pablo18393/in3ator/IN3_hardware/V6/Released/BOM/BOM_PartType-in3ator.xls

Comment | Description | Quantity | Designator
PS1420P02CT | BUZZER, PIEZO, 70DB, 14MM; Transducer Function: Buzzer; Tones: Low Frequency; Supp | 1.0 | BUZ1
100uF 25V 105º SMD 6.6x6.6mm D=6.3mm | 100uF 25V 105º SMD 6.6x6.6mm D=6.3mm | 3.0 | C1, C5, C8
1uF 0603 X5R 16V | 1uF 0603 X5R 16V | 10.0 | C2, C7, C12, C13, C14, C15, C25, C26, C27, C28
10uF 0603 X5R 6.3V | 10uF 0603 X5R 6.3V | 2.0 | C4, C6
100nF 0603 X7R 25V | 100nF 0603 X7R 25V | 11.0 | C9, C11, C19, C22, C24, C29, C30, C31, C32, C33, C35
470uF 16V 105º D=10mm R=5mm | 470uF 16V 105º D=10mm R=5mm | 1.0 | C10
18pF 0603 NPO 5% 50V | 18pF 0603 NPO 5% 50V | 2.0 | C16, C18
1uF 0603 X5R 16V | 1uF 0603 X5R 16V | 1.0 | C17
22pF 0603 NPO 5% 50V | 22pF 0603 NPO 5% 50V | 1.0 | C23
SMBJ15CA | SMBJ15 Series 24.4 V 600 W Bi-Directional Transient Voltage Suppressor-DO-214AA | 1.0 | D1
MBR2045CTI | Schottky Rectifier TO251 Tube 75PCS | 1.0 | D2
ON Semiconductor BAS16HT1G | Diode; Rectifier; Switching; Vr 75VDC; If 200mA; Pkg SOD-323; Vf 1250mV; Trr 6ns; Cj 2pF | 1.0 | D3
S1B....S1M (DO-214) | S1B....S1M (DO-214) | 1.0 | D4
ESDA6V1-5SC6 | ESDA Series 5 Channel 6.1 V 50 pF SMT Uni Directional Transil? Array - SOT-23-6L | 1.0 | D5
Littelfuse 52000001009 + 10A 5X20mm cartridge fuse | Fuse Clip with Ear Through Hole Bulk + 10A 5X20mm cartridge fuse | 1.0 | F1
CG0603MLA-18KE | Var MOV 14VAC 18VDC 30A 24.2V 0603 SMD Paper T/R Var MOV 14VAC 18VDC 30A 24.2V 0603 SMD Paper T/R | 1.0 | F2
BLM18HG601SN1D | BLM18HG601SN1D | 1.0 | FB1
Fiducial | Fiducial | 2.0 | FID1, FID2
Degson 2EDGK-5.08-02P-14-00AH | Terminal block, 5mm 2 Pos, through hole male. | 1.0 | J1
Degson 2EDGK-5.08-04P-14-00AH | Terminal block, 5.08mm 4 Pos, through hole male. | 1.0 | J4
Camden Boss CTBP93HD/8 | 3.5mm pluggable terminal block, header, 8P | 1.0 | J5
JST B2B-XH-A(LF)(SN) | XH Series 2 Position 2.5 mm Pitch Through Hole Top Entry Shrouded Header | 2.0 | J7, J10
JST B3B-XH-A (LF)(SN) | XH Series 3 Position 2.5 mm Pitch Through Hole Crimp Top Entry Shrouded Header | 1.0 | J9
TE Connectivity 2-1761603-1 | Wire-To-Board Connector, AMP-LATCH Series, Through Hole, Header, 6, 2.54 mm, Gold Plated Contacts | 1.0 | J11
SYM-d1a918a3c97c0e6e-1 | Relay; E-Mech; Gen Purp; DPDT; Cur-Rtg 8A; Ctrl-V 12DC; Vol-Rtg 277/30AC/DC; PCB Mnt | 1.0 | K1
Bourns SRN6045TA-221M | Inductor Power Semi-Shielded Wirewound 220uH 20% 1MHz 15Q-Factor Ferrite 0.6A 0.9Ohm DCR 2424 Automotive T/R | 1.0 | L1
Murata NCP18XH103F03RB | Thermistor NTC 10K Ohm 1% 2-Pin 0603 Surface Mount Solder Pad 3434K T/R | 2.0 | NTC1, NTC2
BC817-16 | TRANS NPN 45V 500mA SMD SOT23-3 | 3.0 | Q1, Q2, Q9
IRLB8314PbF | MOSFET Transistor, N Channel, 130 A, 30 V, 0.0019 ohm, 10 V, 1.7 V | 1.0 | Q3
STP40NF03L | STP40NF03L | 5.0 | Q4, Q5, Q6, Q7, Q8
NTR1P02LT1G | Power MOSFET, -20 V, -1.3 A, P-Channel, 3-Pin SOT-23, Pb-Free, Tape and Reel | 1.0 | Q10
0.02R 1206 0.5W 1% | 0.02R 1206 0.5W 1% | 2.0 | R3, R4
10K 0603 0.1W 1% | 10K 0603 0.1W 1%, 10K 0603 0.1W 1%, 10K 0603 0.1W 1%, 10K 0603 0.1W 1%, 10K 0603 0.1W 1%, 10K 0603 0.1W 1%, 10K 0603 0.1W 1%, 10K 0603 0.1W 1%, 10K 0603 0.1W 1%, 10K 0603 0.1W 1%, 10K 0603 0.1W 1%, 10K 0603 0.1W 1%, 10K 0603 0.1W 1%, 10K 0603 0.1W 1%, 10K 0603 0.1W 1%, 10K 0603 0.1W 1%, 10K 0603 0.1W 1%, 10K 0603 0.1W 1%, 10K 0603 0.1W 1%, 10K 0603 0.1W 1%, 30K 0603 0.1W 1%, 10K 0603 0.1W 1% | 22.0 | R5, R7, R10, R11, R13, R14, R21, R27, R37, R40, R45, R46, R50, R52, R53, R54, R57, R58, R59, R62, R68, R72
30K 0603 0.1W 1% | 30K 0603 0.1W 1% | 3.0 | R6, R30, R61
4K7 0603 0.1W 1% | 4K7 0603 0.1W 1% | 2.0 | R8, R36
2K 0603 0.1W 1% | 2K 0603 0.1W 1% | 3.0 | R9, R12, R29
22R 0603 0.1W 1% | 22R 0603 0.1W 1% | 5.0 | R15, R16, R32, R33, R34
100R 0603 0.1W 1% | 100R 0603 0.1W 1% | 8.0 | R17, R18, R19, R20, R22, R23, R65, R69
0R 0603 0.1W 1% | 0R 0603 0.1W 1% | 5.0 | R24, R31, R66, R70, R81
1K 0603 0.1W 1% | 1K 0603 0.1W 1% | 7.0 | R25, R26, R28, R55, R60, R63, R64
100K 0603 0.1W 1% | 100K 0603 0.1W 1% | 4.0 | R35, R42, R47, R48
22K 0603 0.1W 1% | 22K 0603 0.1W 1% | 3.0 | R44, R49, R51
TE Connectivity 5-1814832-1 | RF Connectors / Coaxial Connectors Str PCB Skt | 1.0 | RF_CON1
Bourns PEC11R-4215F-S0024 | 12 mm Incremental Encoder, 24 Detent, -30 to 70 degC, 5-Pin THD, RoHS, Bulk | 1.0 | SW2
MCP1703T-3302E/CB | MCP1703T-3302E/CB | 2.0 | U1, U2
Micrel MIC29302WU | MIC29302 Series 3 A 1.24 to 26 V ADJ Output Voltage LDO Regulator - TO-263-5 | 1.0 | U3
MCP1703T-5002E/CB | 250 mA, 16V, Low Quiescent Current LDO Regulator, 3-Pin SOT-23A, Extended Temperature, Tape and Reel | 1.0 | U4
STM32F103RET6 | ARM Cortex-M3 32-bit MCU, 512 KB Flash, 64 KB Internal RAM, 51 I/Os, 64-pin LQFP, -40 to 85 degC, Tray | 1.0 | U5
Simcom SIM800C | Module: GSM/Bluetooth; GPRS; 2G; 1800MHz, 900MHz; 85.6kbps; SMD | 1.0 | U6
MCP6L02T-E/MS | Microchip MCP6L02T-E/MS, Dual Op Amp, 1MHz Rail-Rail, 1.8 to 6 V, 8-Pin MSOP | 1.0 | U8
2.2 / 2.4 tft compatible (touch / no touch) | TZT 2.4" 240x320 SPI TFT LCD Serial Port Module+5V/3.3V PBC Adapter Micro SD ILI9341 | 1.0 | U10
Bosch BME280 | Combined humidity and pressure sensor | 1.0 | U11
CX5032GB08000H0HPQZ1 | Crystal 8Mhz 30ppm -40ºC/+85ºC 12pF 300ohm | 1.0 | Y1
