pablo18393/in3ator/IN3_hardware/V2.B/Released/in3ator.PDF

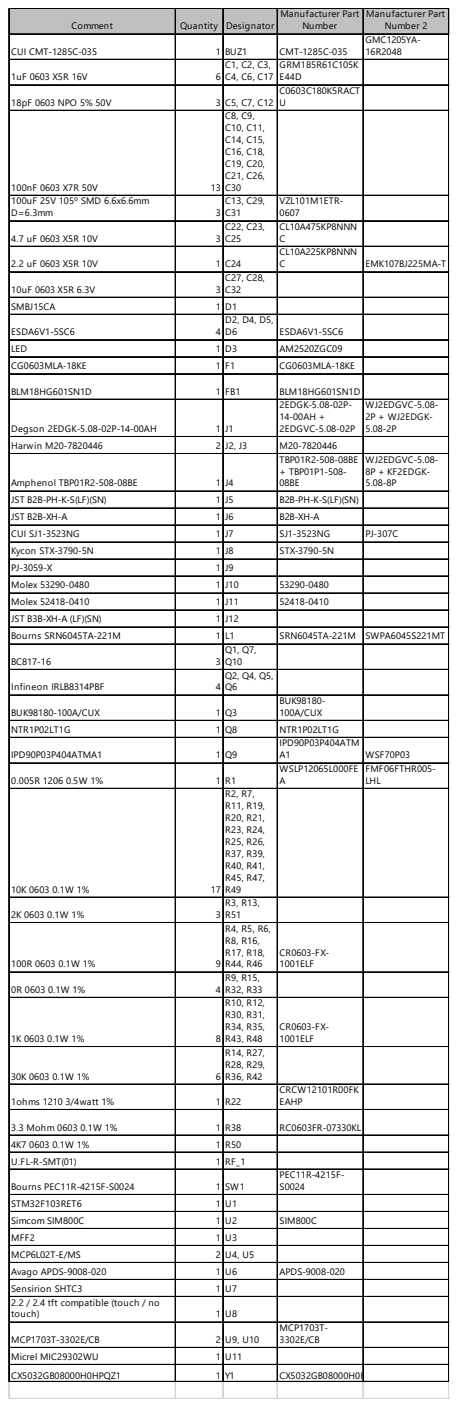
[picture p1: page 1]

Comment | Quantity | Designator | Manufacturer Part Number | Manufacturer Part Number 2

CUI CMT-1285C-035 | 1 | BUZ1 | CMT-1285C-035 | GMC1205YA-16R2048

1uF 0603 X5R 16V | 6 | C1, C2, C3, C4, C6, C17 | GRM185R61C105K E44D

18pF 0603 NPO 5% 50V | 3 | C5, C7, C12 | C0603C180K5RACT U

100uF 25V 105º SMD 6.6x6.6mm D=6.3mm | 3 | C13, C29, C31 | VZL101M1ETR-0607

4.7 uF 0603 X5R 10V | 3 | C22, C23, C25 | CL10A475KP8NNN C

2.2 uF 0603 X5R 10V | 1 | C24 | CL10A225KP8NNN C | EMK107BJ225MA-T

SMBJ15CA | 1 | D1
ESDA6V1-5SC6 | 4 | D2, D4, D5, D6 | ESDA6V1-5SC6

LED | 1 | D3 | AM2520ZGC09

CG0603MLA-18KE | 1 | F1 | CG0603MLA-18KE

BLM18HG601SN1D | 1 | FB1 | BLM18HG601SN1D
Degson 2EDGK-5.08-02P-14-00AH | 1 | J1 | 2EDGK-5.08-02P-14-00AH + 2EDGVC-5.08-02P | WJ2EDGVC-5.08-2P + WJ2EDGK-5.08-2P

Harwin M20-7820446 | 2 | J2, J3 | M20-7820446
Amphenol TBP01R2-508-08BE | 1 | J4 | TBP01R2-508-08BE + TBP01P1-508-08BE | WJ2EDGVC-5.08-8P + KF2EDGK-5.08-8P

JST B2B-PH-K-S(LF)(SN) | 1 | J5 | B2B-PH-K-S(LF)(SN)

JST B2B-XH-A | 1 | J6 | B2B-XH-A

CUI SJ1-3523NG | 1 | J7 | SJ1-3523NG | PJ-307C

Kycon STX-3790-5N | 1 | J8 | STX-3790-5N

Molex 53290-0480 | 1 | J10 | 53290-0480

Molex 52418-0410 | 1 | J11 | 52418-0410

JST B3B-XH-A (LF)(SN) | 1 | J12

Bourns SRN6045TA-221M | 1 | L1 | SRN6045TA-221M | SWPA6045S221MT
BC817-16 | 3 | Q1, Q7, Q10

Infineon IRLB8314PBF | 4 | Q2, Q4, Q5, Q6

BUK98180-100A/CUX | 1 | Q3 | BUK98180-100A/CUX

NTR1P02LT1G | 1 | Q8 | NTR1P02LT1G
IPD90P03P404ATMA1 | 1 | Q9 | IPD90P03P404ATM A1 | WSF70P03

0.005R 1206 0.5W 1% | 1 | R1 | WSLP12065L000FE A | FMF06FTHR005-LHL

100R 0603 0.1W 1% | 9 | R4, R5, R6, R8, R16, R17, R18, R44, R46 | CR0603-FX-1001ELF

1K 0603 0.1W 1% | 8 | R10, R12, R30, R31, R34, R35, R43, R48 | CR0603-FX-1001ELF

1ohms 1210 3/4watt 1% | 1 | R22 | CRCW12101R00FK EAHP

3.3 Mohm 0603 0.1W 1% | 1 | R38 | RC0603FR-07330KL

U.FL-R-SMT(01) | 1 | RF_1
Bourns PEC11R-4215F-S0024 | 1 | SW1 | PEC11R-4215F-S0024

STM32F103RET6 | 1 | U1

Simcom SIM800C | 1 | U2 | SIM800C

MFF2 | 1 | U3

MCP6L02T-E/MS | 2 | U4, U5

Avago APDS-9008-020 | 1 | U6 | APDS-9008-020

Sensirion SHTC3 | 1 | U7
2.2 / 2.4 tft compatible (touch / no touch) | 1 | U8

MCP1703T-3302E/CB | 2 | U9, U10 | MCP1703T-3302E/CB

Micrel MIC29302WU | 1 | U11

CX5032GB08000H0HPQZ1 | 1 | Y1 | CX5032GB08000H0H

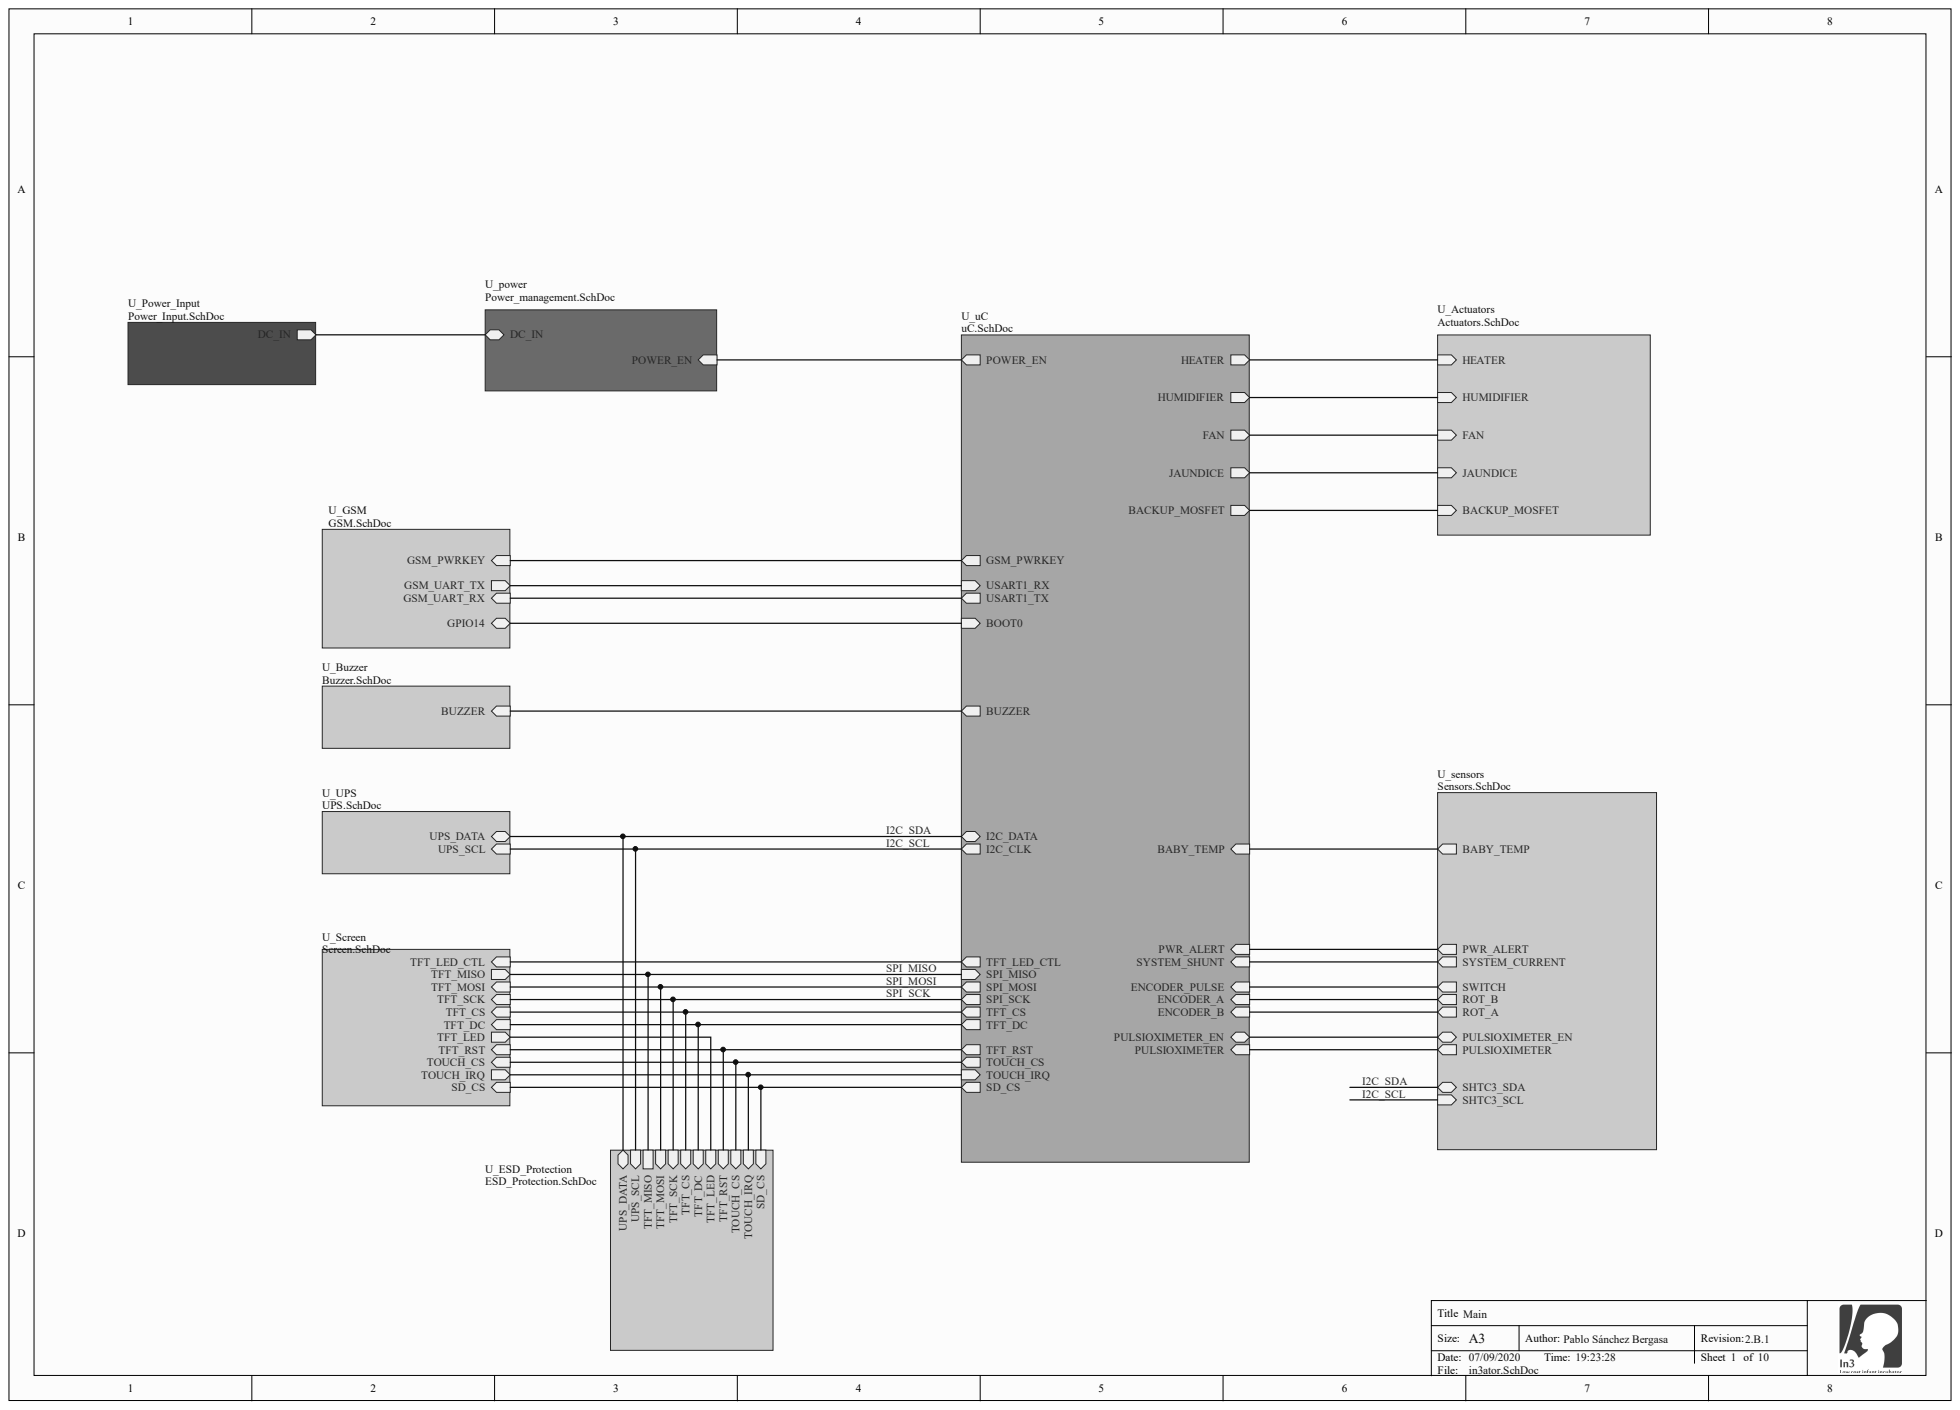
[picture p2: page 2]
Title Size:; Author; ROT_B ROT_A PULSIOXIMETER_EN SHTC3_SCL SHTC3_SDA PWR_ALERT PULSIOXIMETER BABY_TEMP; POWER_EN BOOT0; I2C_CLK SPI_MISO SPI_SCK SPI_MOSI; IOXIMETER PWR_ALERT; chDoc DC_IN; FAN BACKUP_MOS; I2C_SDA I2C_SCL

NLSPI0MISO S P I_MI S O
NLSPI0MOSI S P I_MOS I
NLSPI0SCK S P I_S C K

Main

A | : P ablo S ánche z B e rgasa | R evision: 2.B.1

File : in3ator.S chDoc

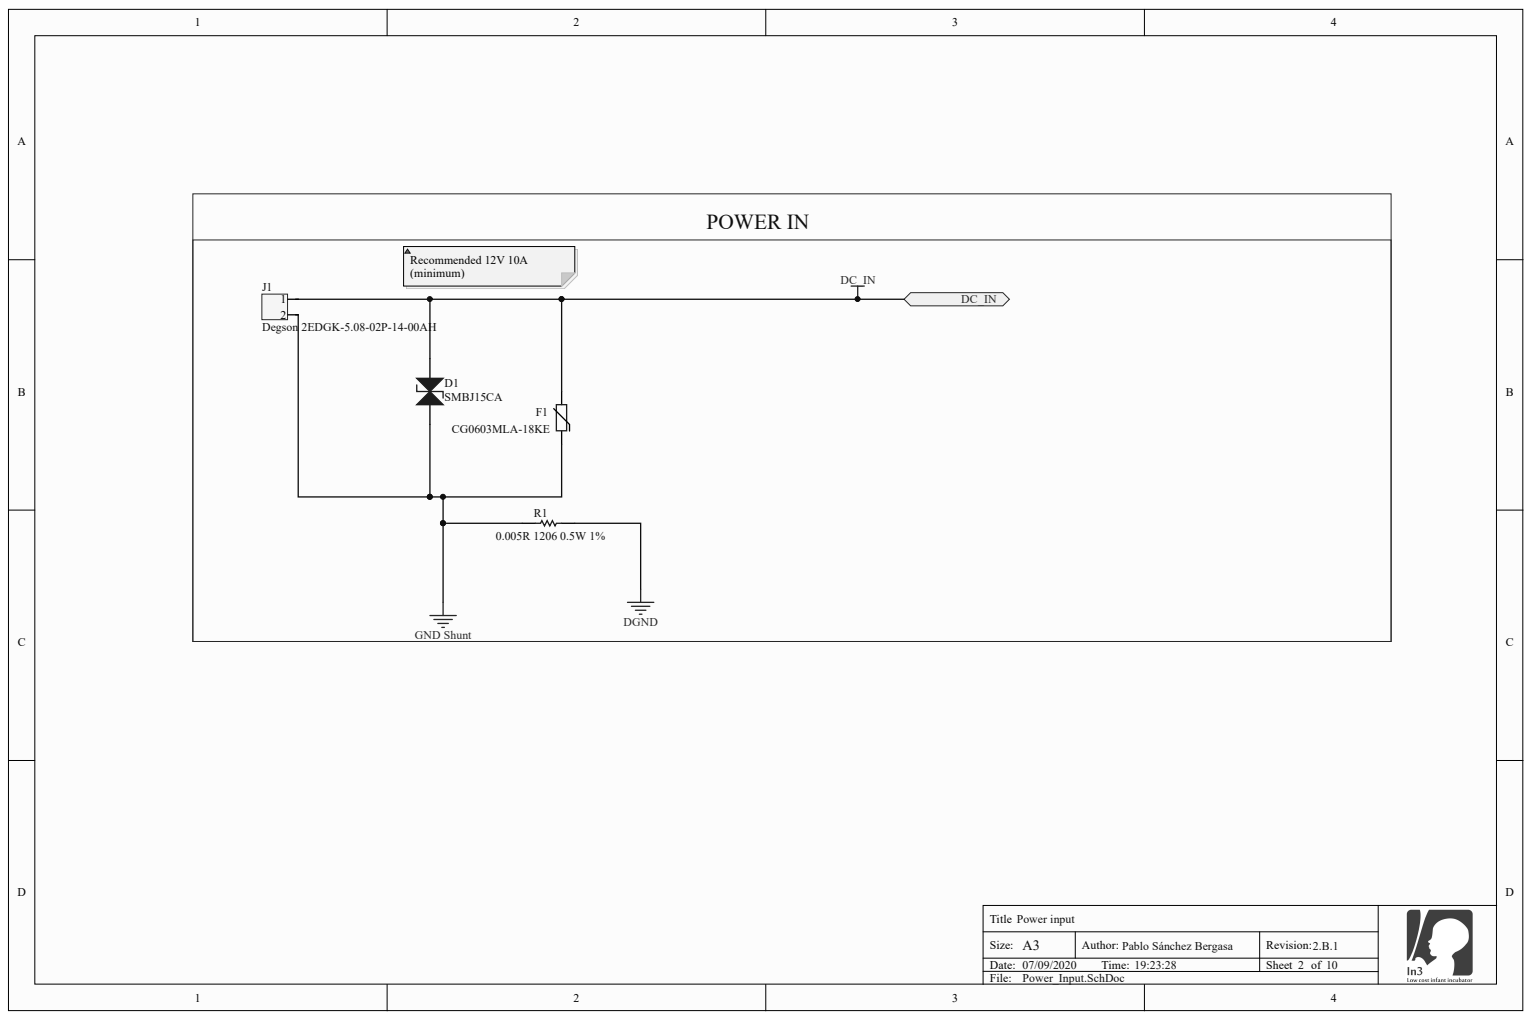
[picture p3: page 3]
POWER IN; D Shunt; J1Degson 2ED; mended 12V 10A

T i t l e Power input

Size: A3 | Author: Pablo S ánchez Bergasa | Revision: 2. B . 1
Date: T i me: | | Sheet of

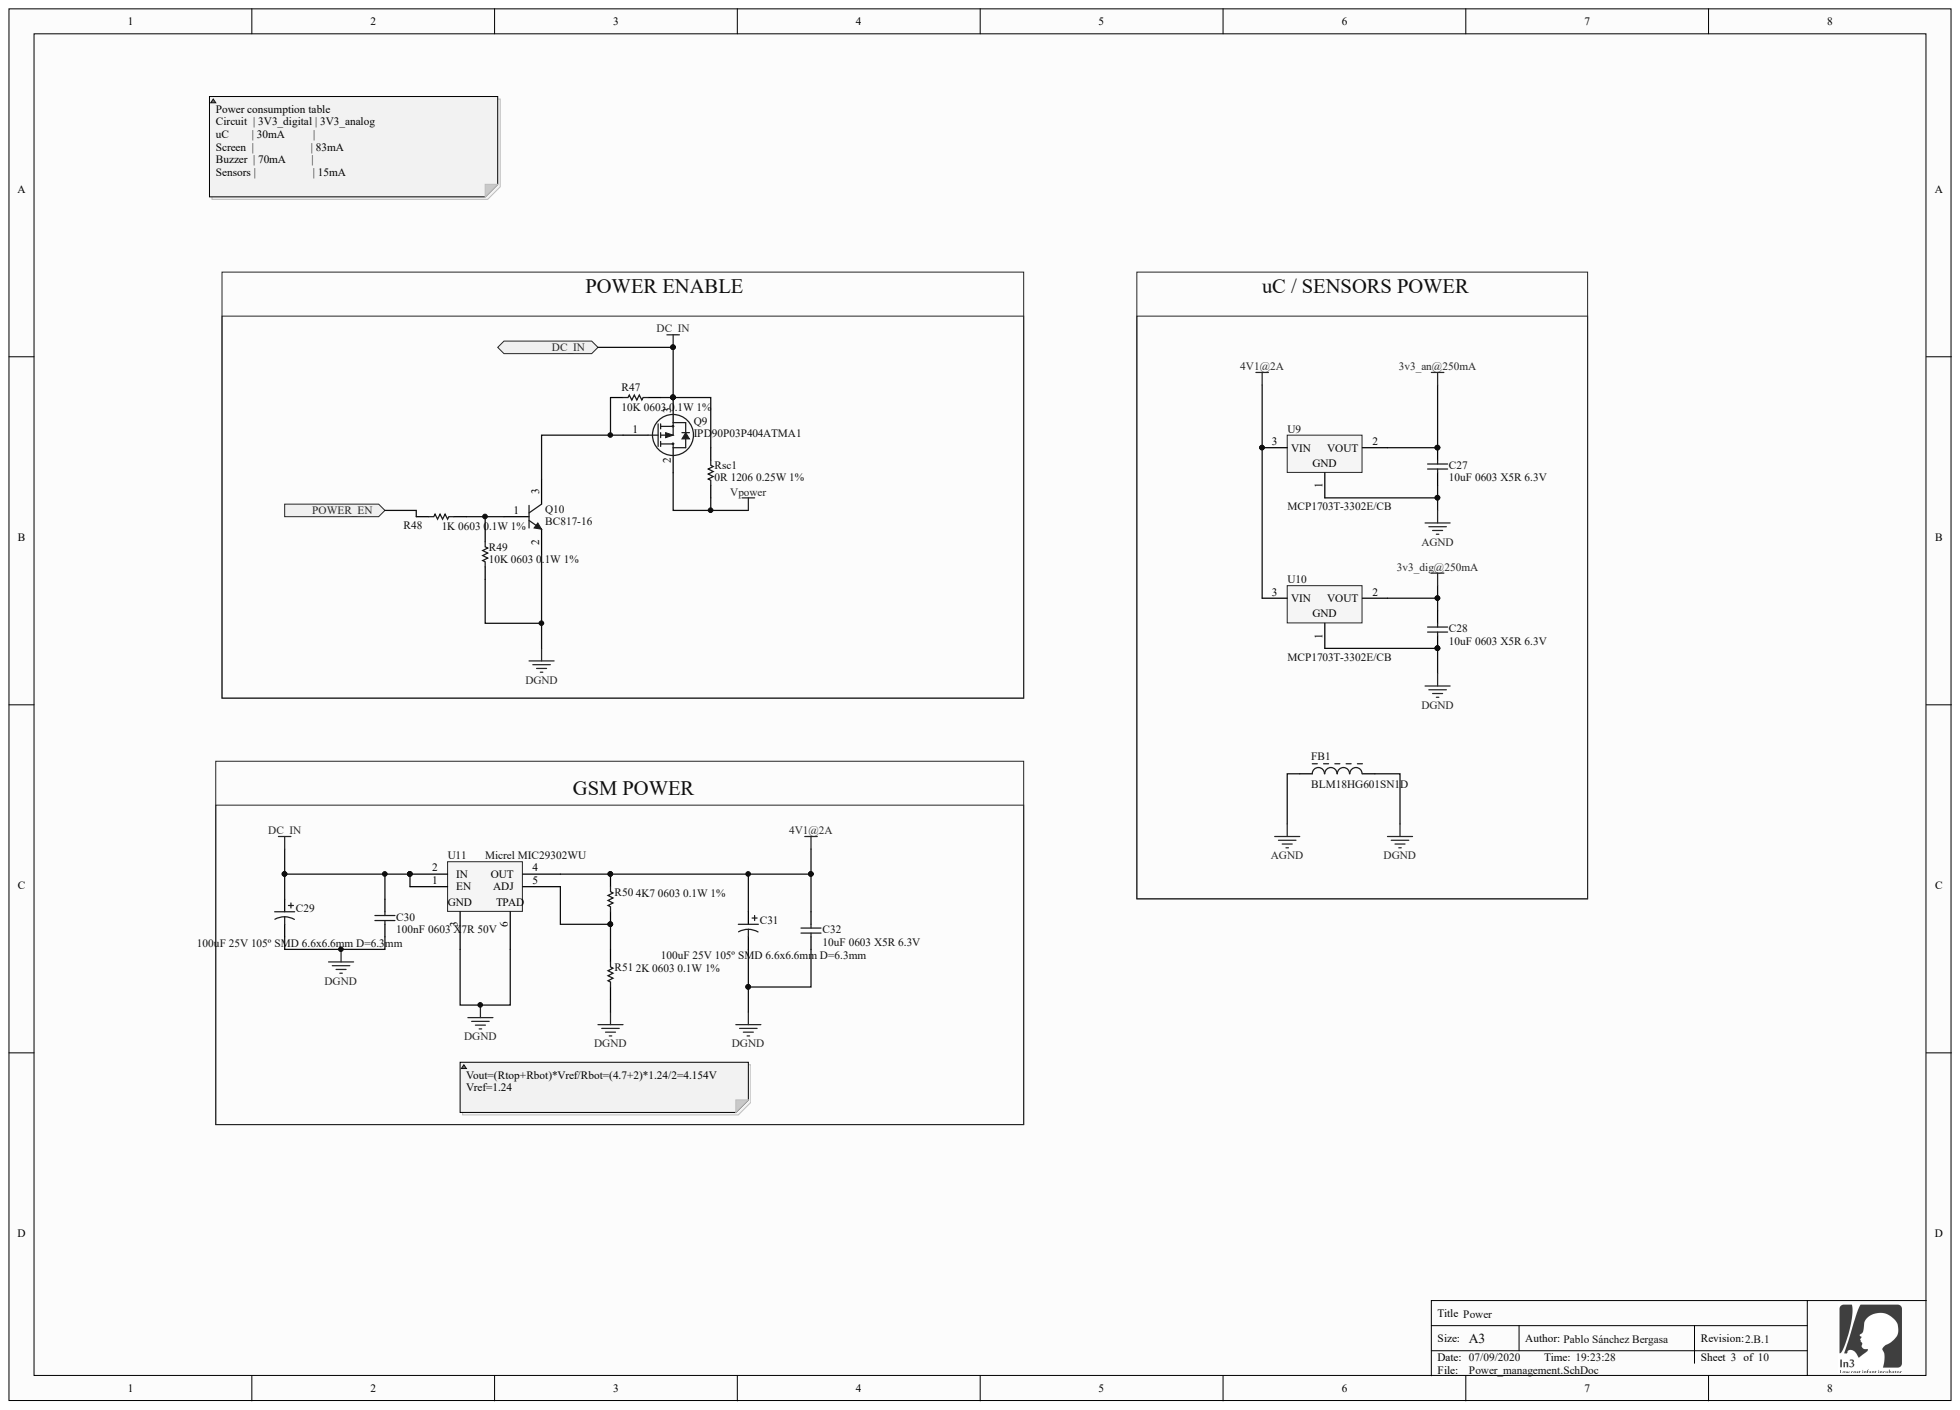
[picture p4: page 4]

Vout=(Rtop+Rbot)*Vref/Rbot=(4.7+2)*1.24/2=4.154V
Vref=1.24

Title Power

Size: A3 | Author: Pablo Sánchez Bergasa | Revision: 2.B.1

File: Power_management.SchDoc

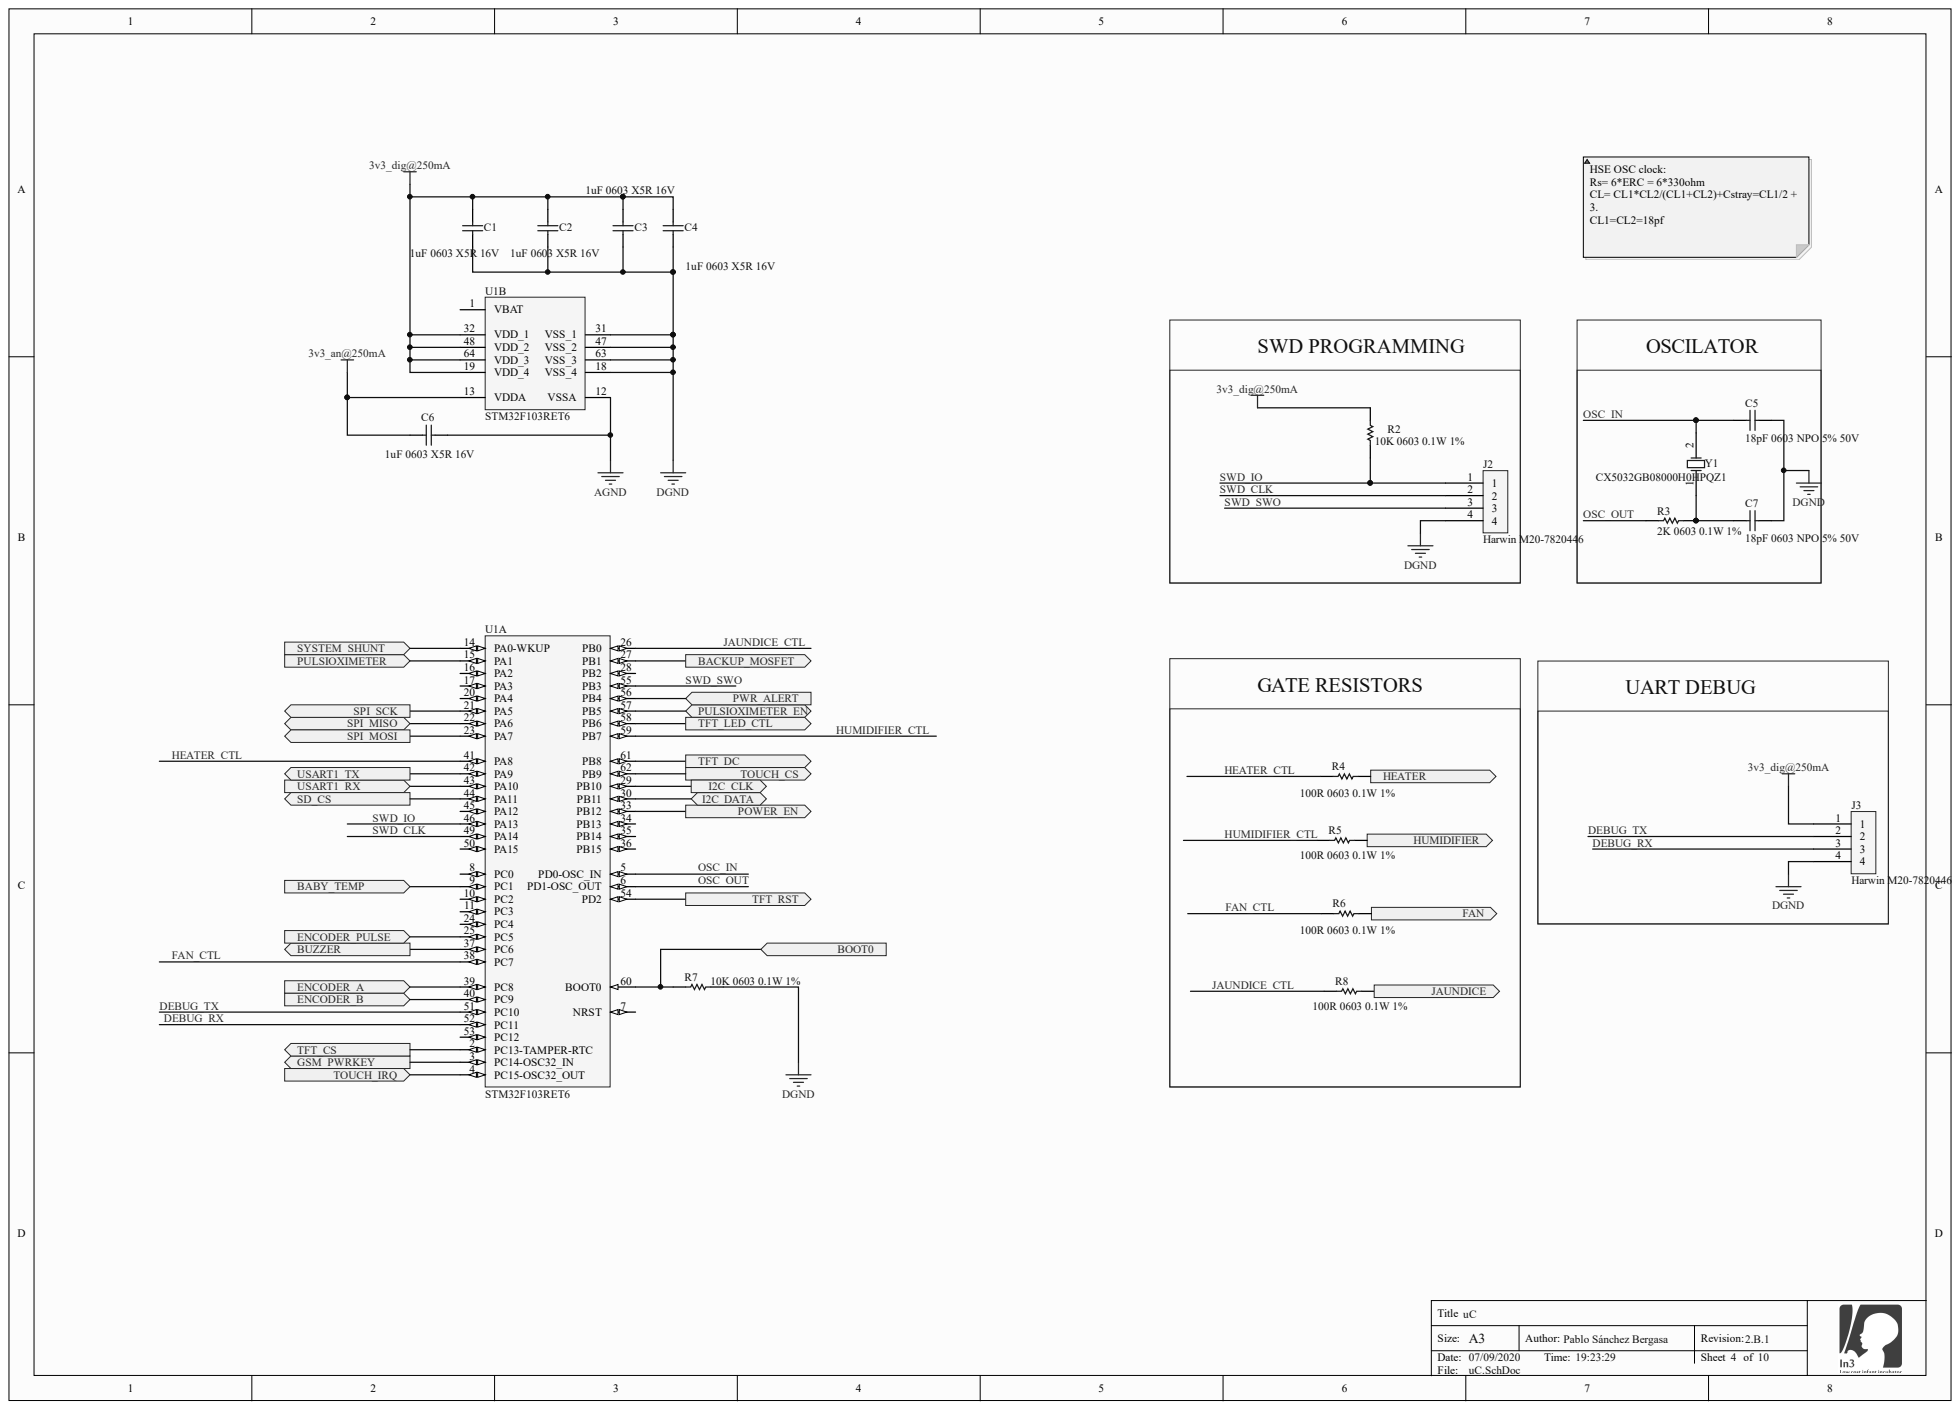
[picture p5: page 5]

Title uC

Size: A3 | Author: Pablo Sánchez Bergasa | Revision: 2.B.1

uC.SchDoc

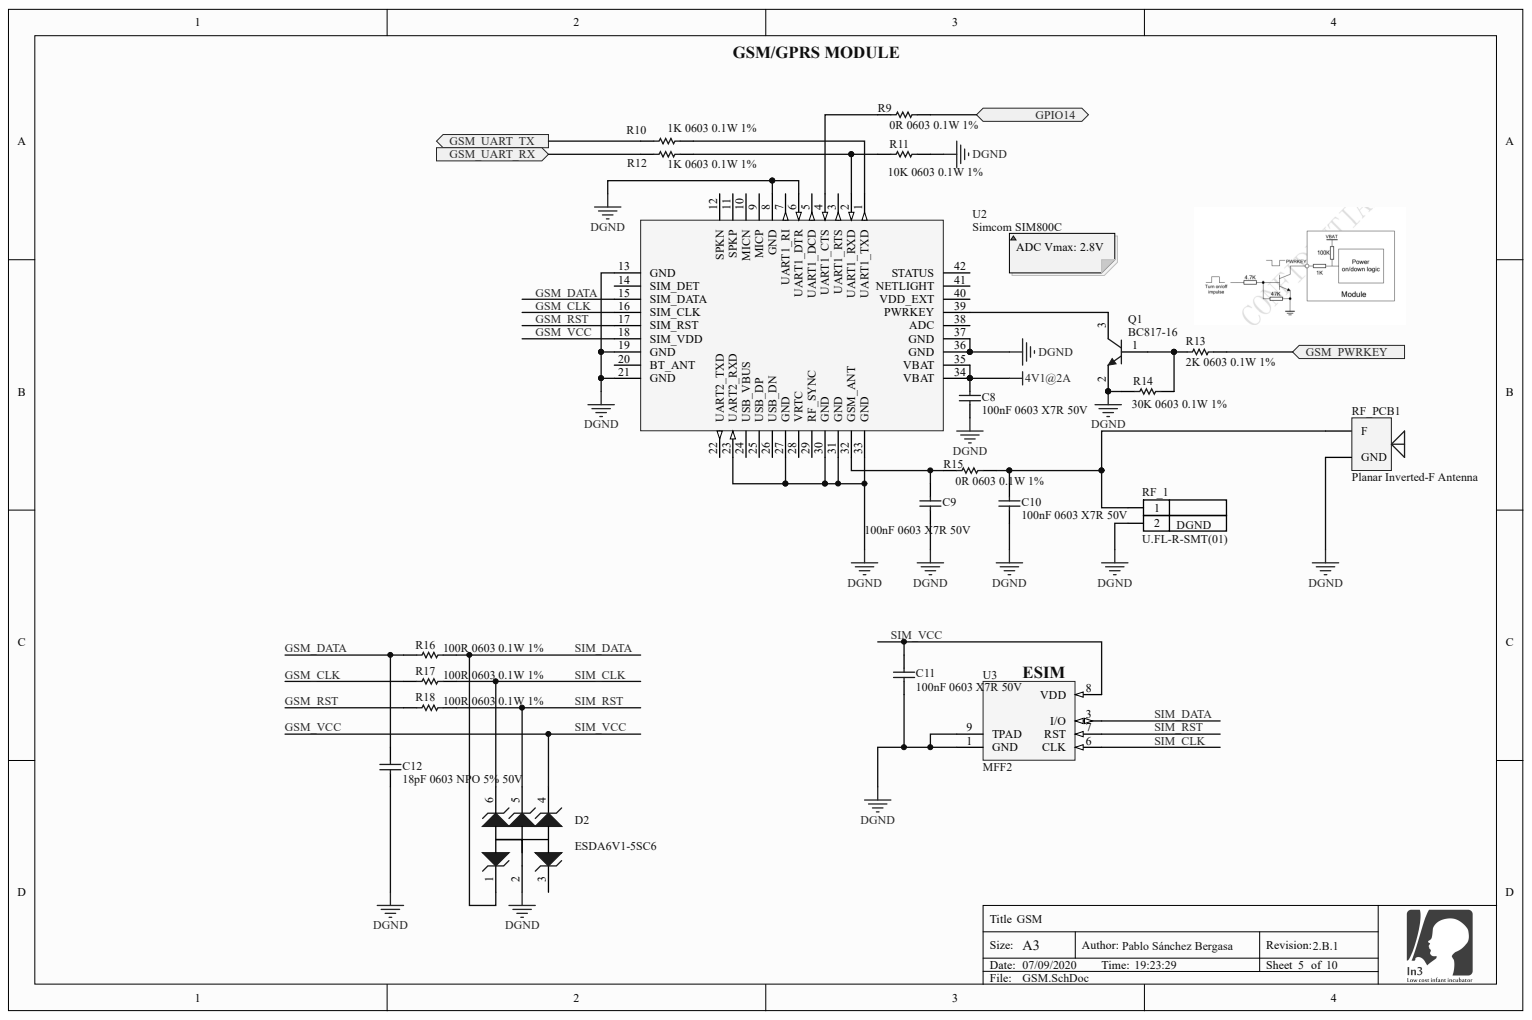
[picture p6: page 6]

SIM_DET 14

SIM_CLK 16
SIM_RST 17
SIM_VDD 18
GND 19
BT_ANT 20

2 | DGND

Title GSM

Size: A3 | Author: Pablo Sánchez Bergasa | Revision: 2.B.1

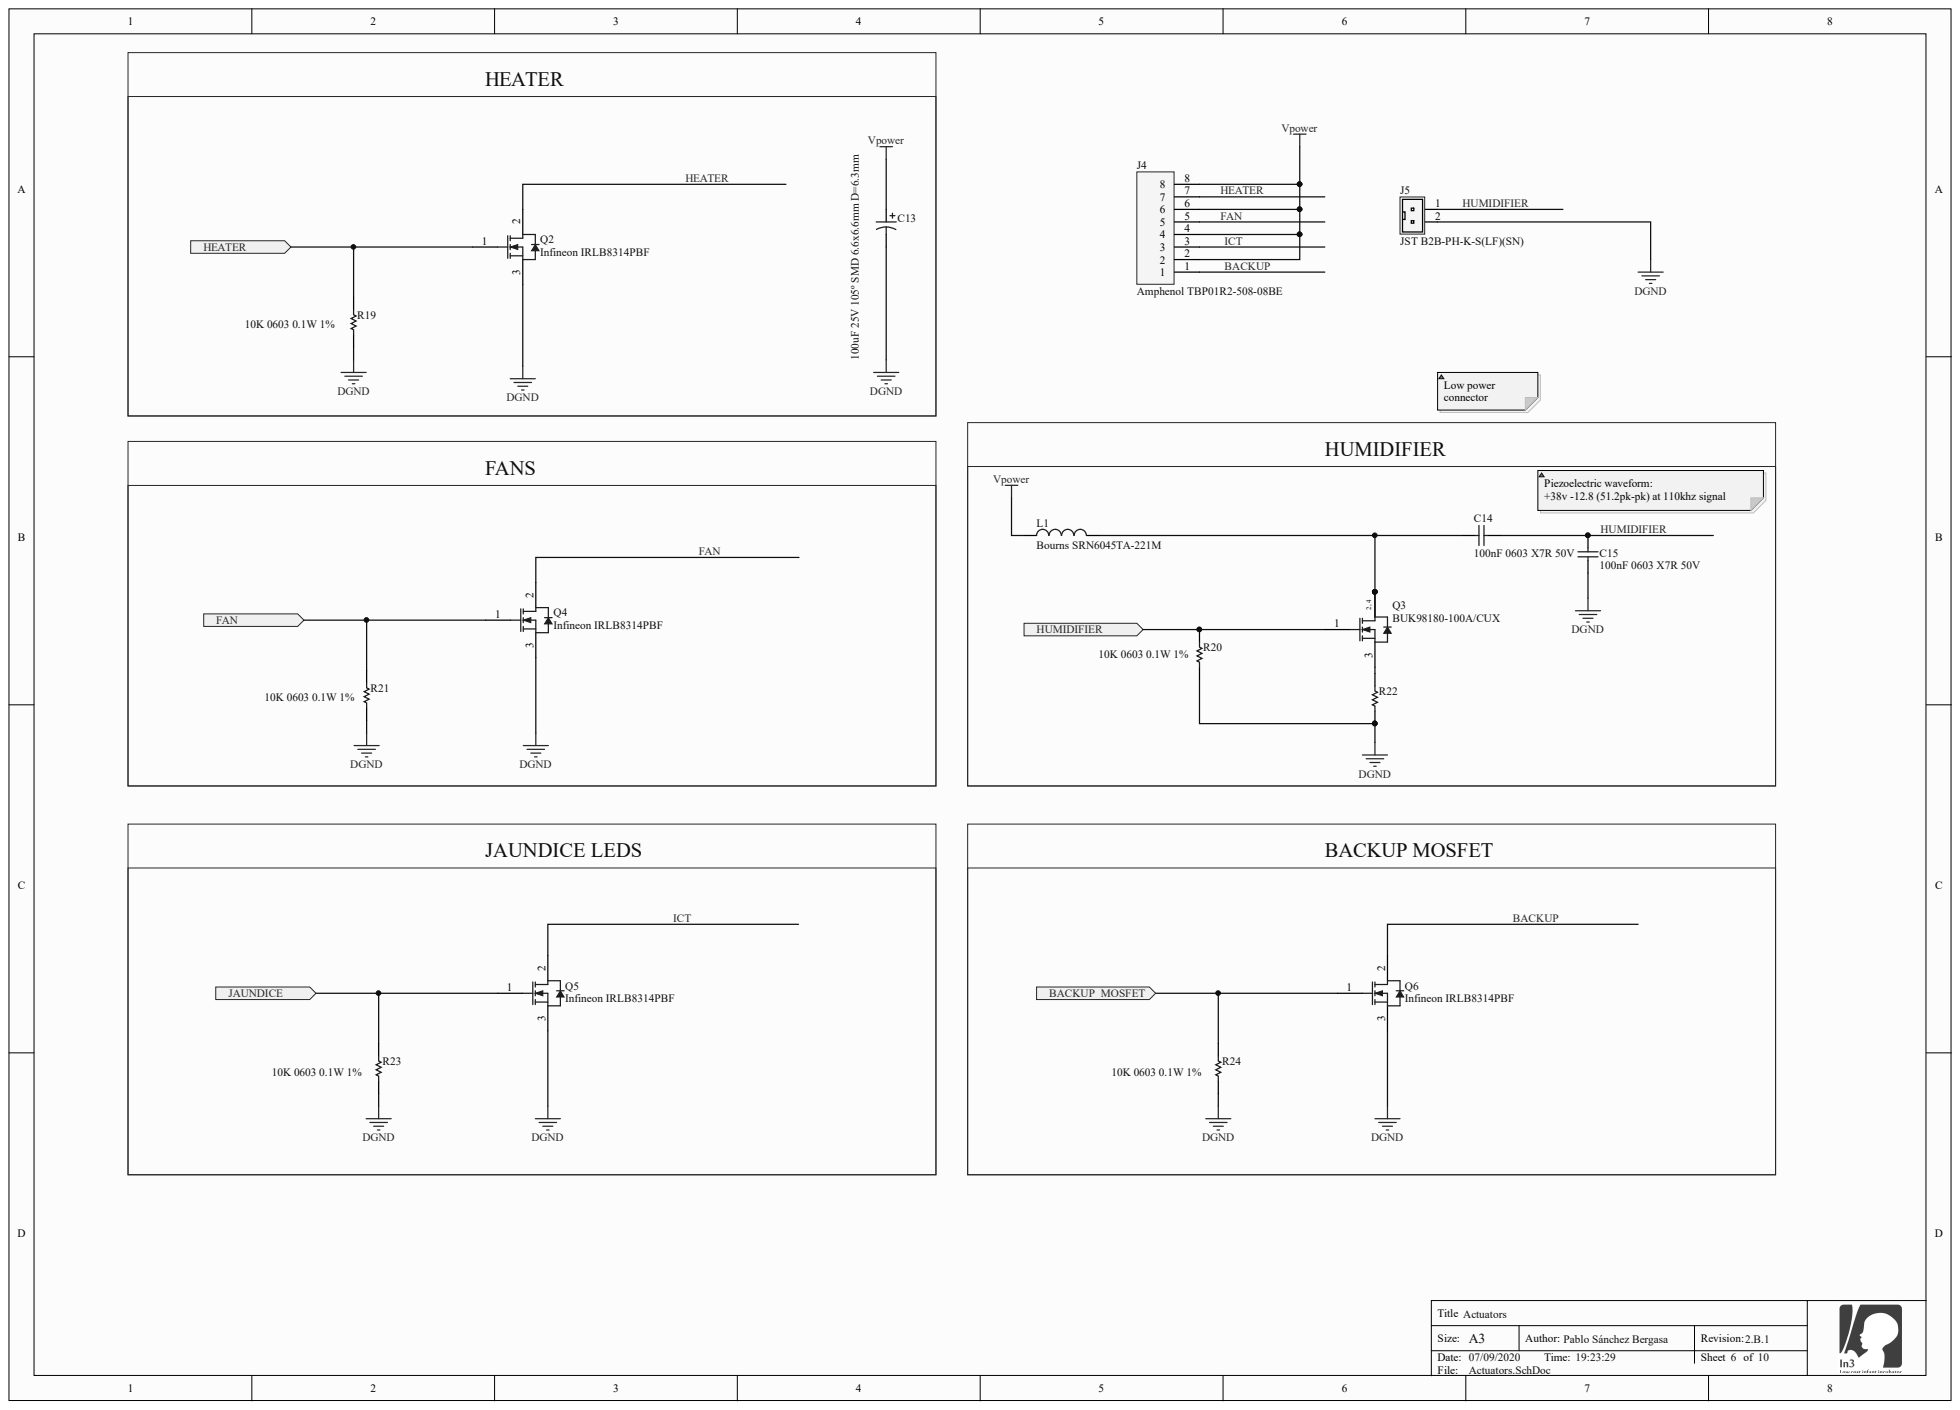
[picture p7: page 7]

FAN

ICT

JST B2B-PH-K-S(LF)(SN)

Title Actuators

Size: A3 | Author: Pablo Sánchez Bergasa | Revision: 2.B.1

Actuators.SchDoc

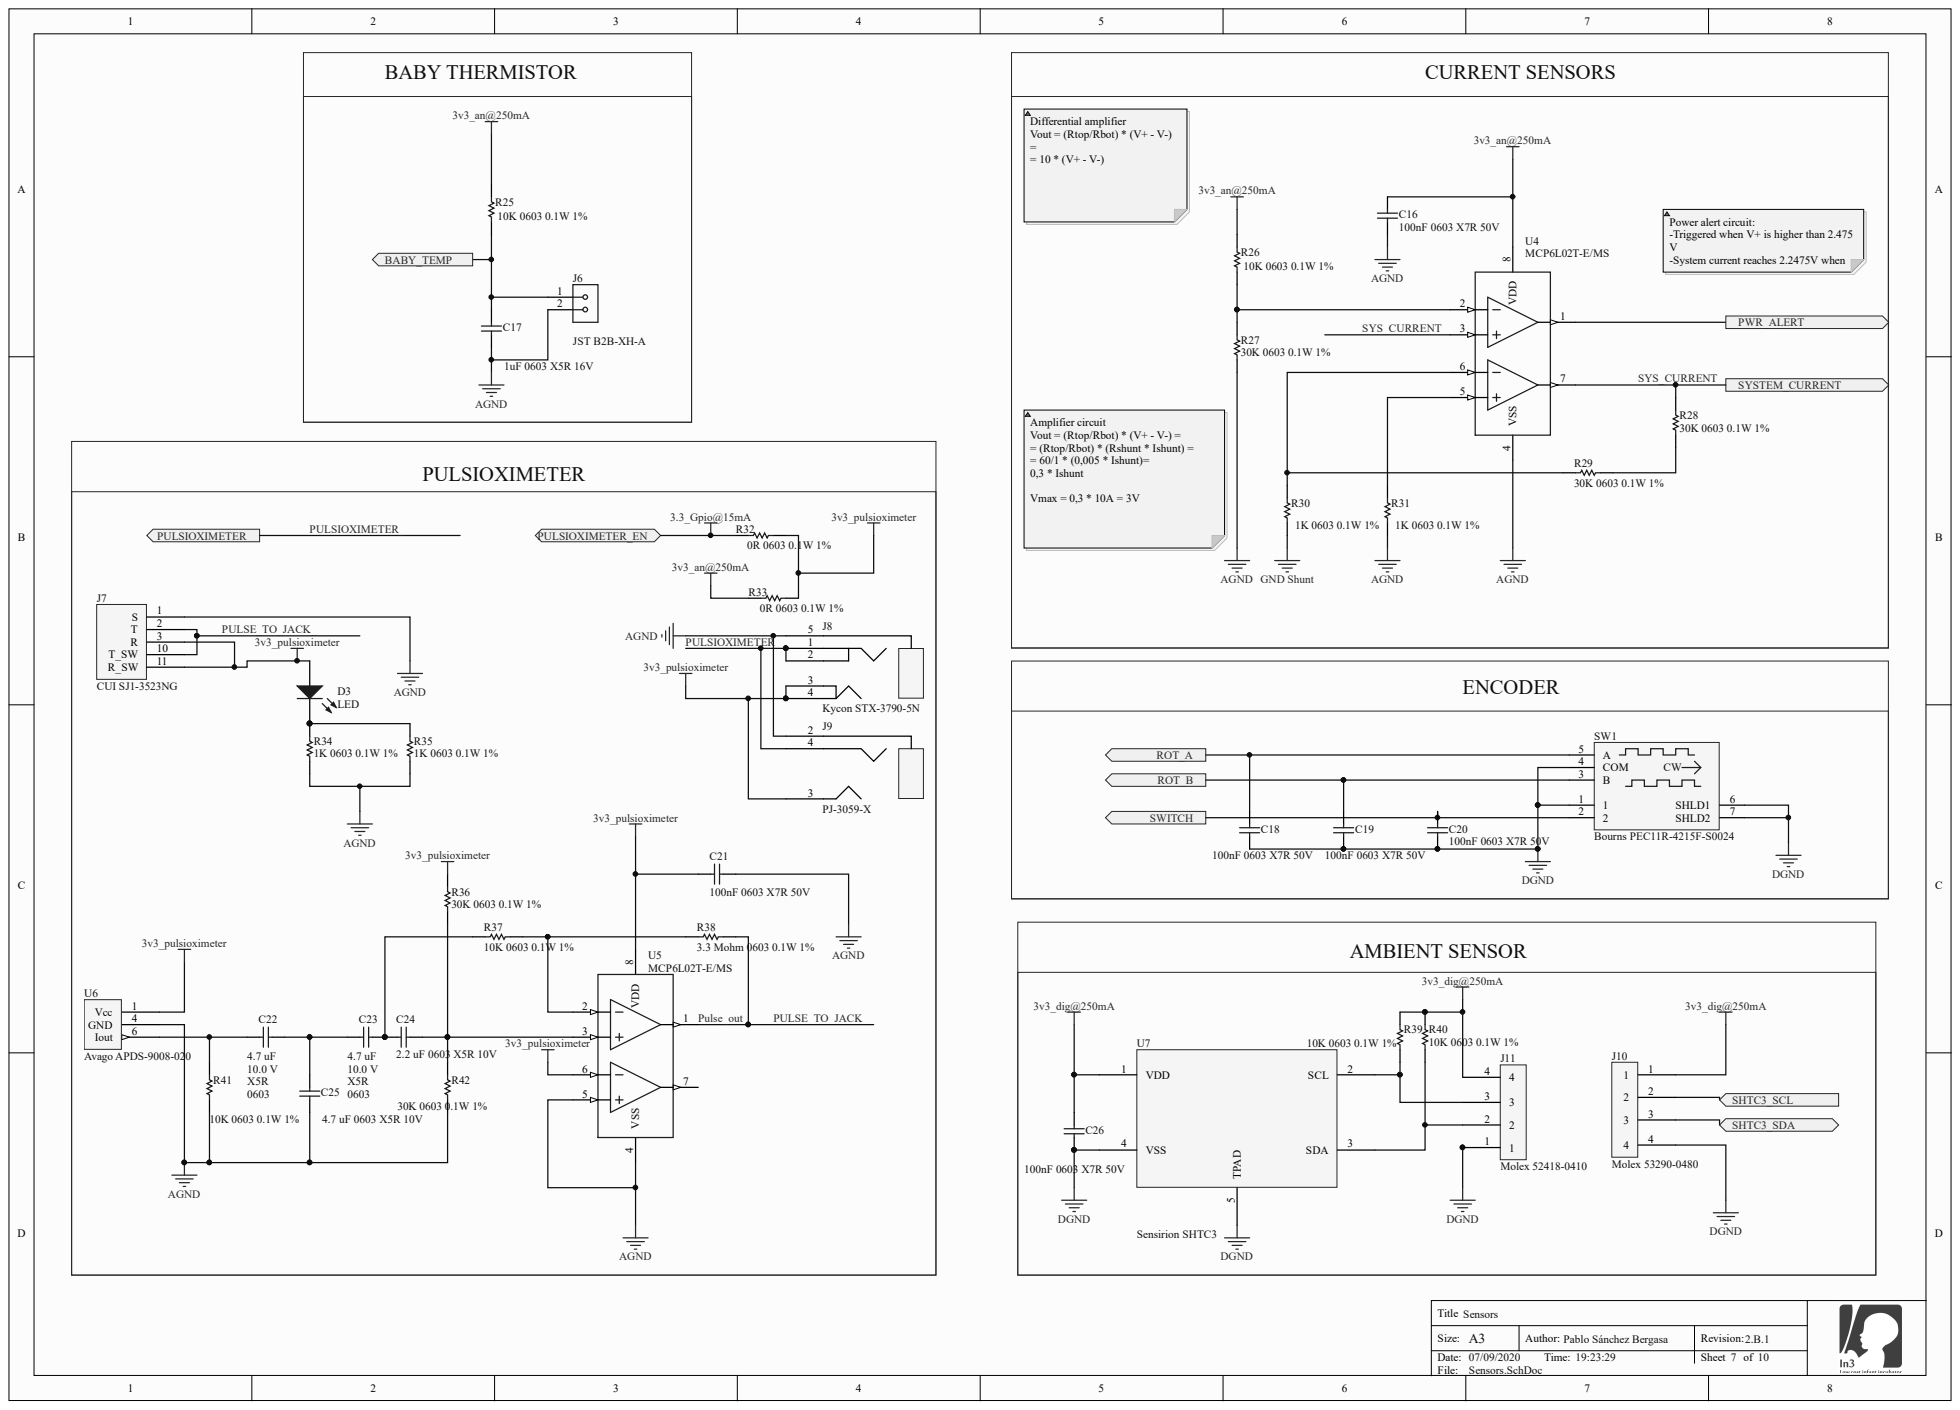
[picture p8: page 8]

Power alert circuit:
-Triggered when V+ is higher than 2.475
-System current reaches 2.2475V when

Amplifier circuit
Vout = (Rtop/Rbot) * (V+ - V-) =
= (Rtop/Rbot) * (Rshunt * Ishunt) =
= 60/1 * (0,005 * Ishunt)=
0,3 * Ishunt

PULSIOXIMETER_ | 1

2 Kycon STX-3790-5N

2 J9

Title Sensors

Size: A3 | Author: Pablo Sánchez Bergasa | Revision: 2.B.1

Sensors.SchDoc

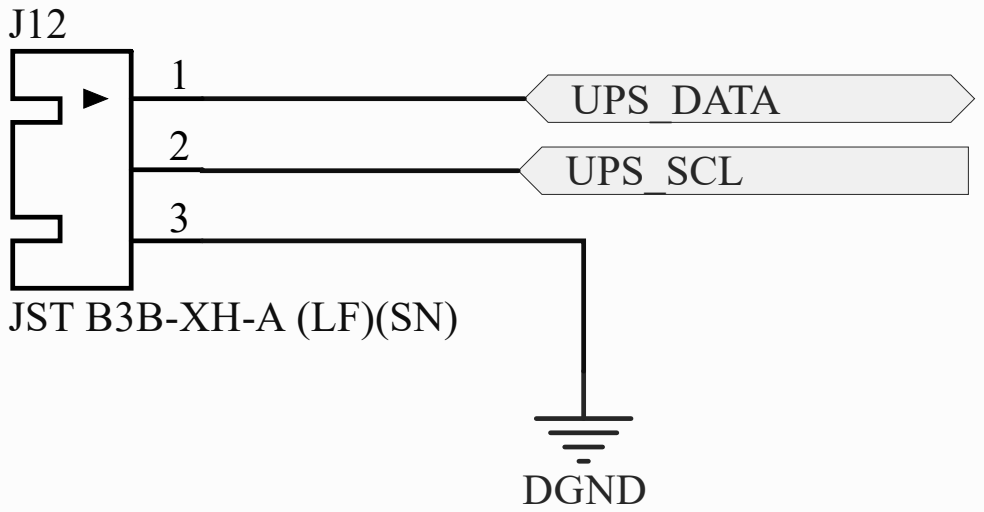
[picture p9: page 9]

JST B3B-XH-A (LF)(SN)

Title UPS

Size: A3 | Author: Pablo Sánchez Bergasa | Revision: 2.B.1

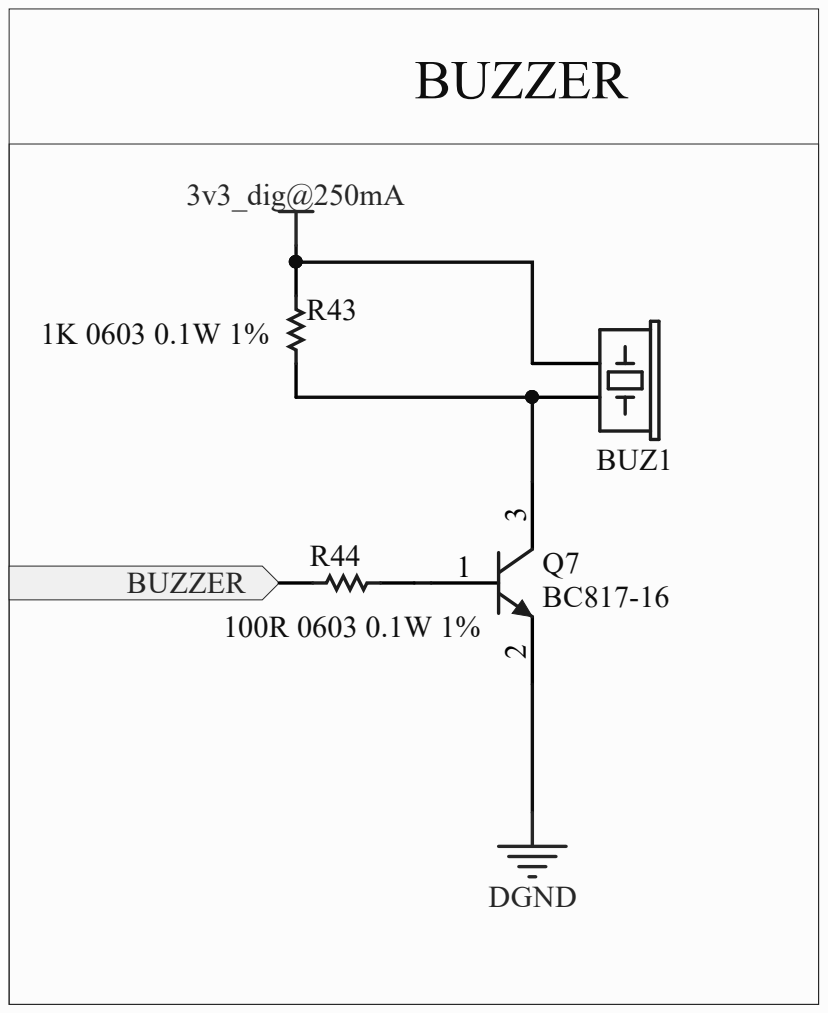
[picture p10: page 10]

Title Buzzer

Size: A3 | Author: Pablo Sánchez Bergasa | Revision: 2.B.1

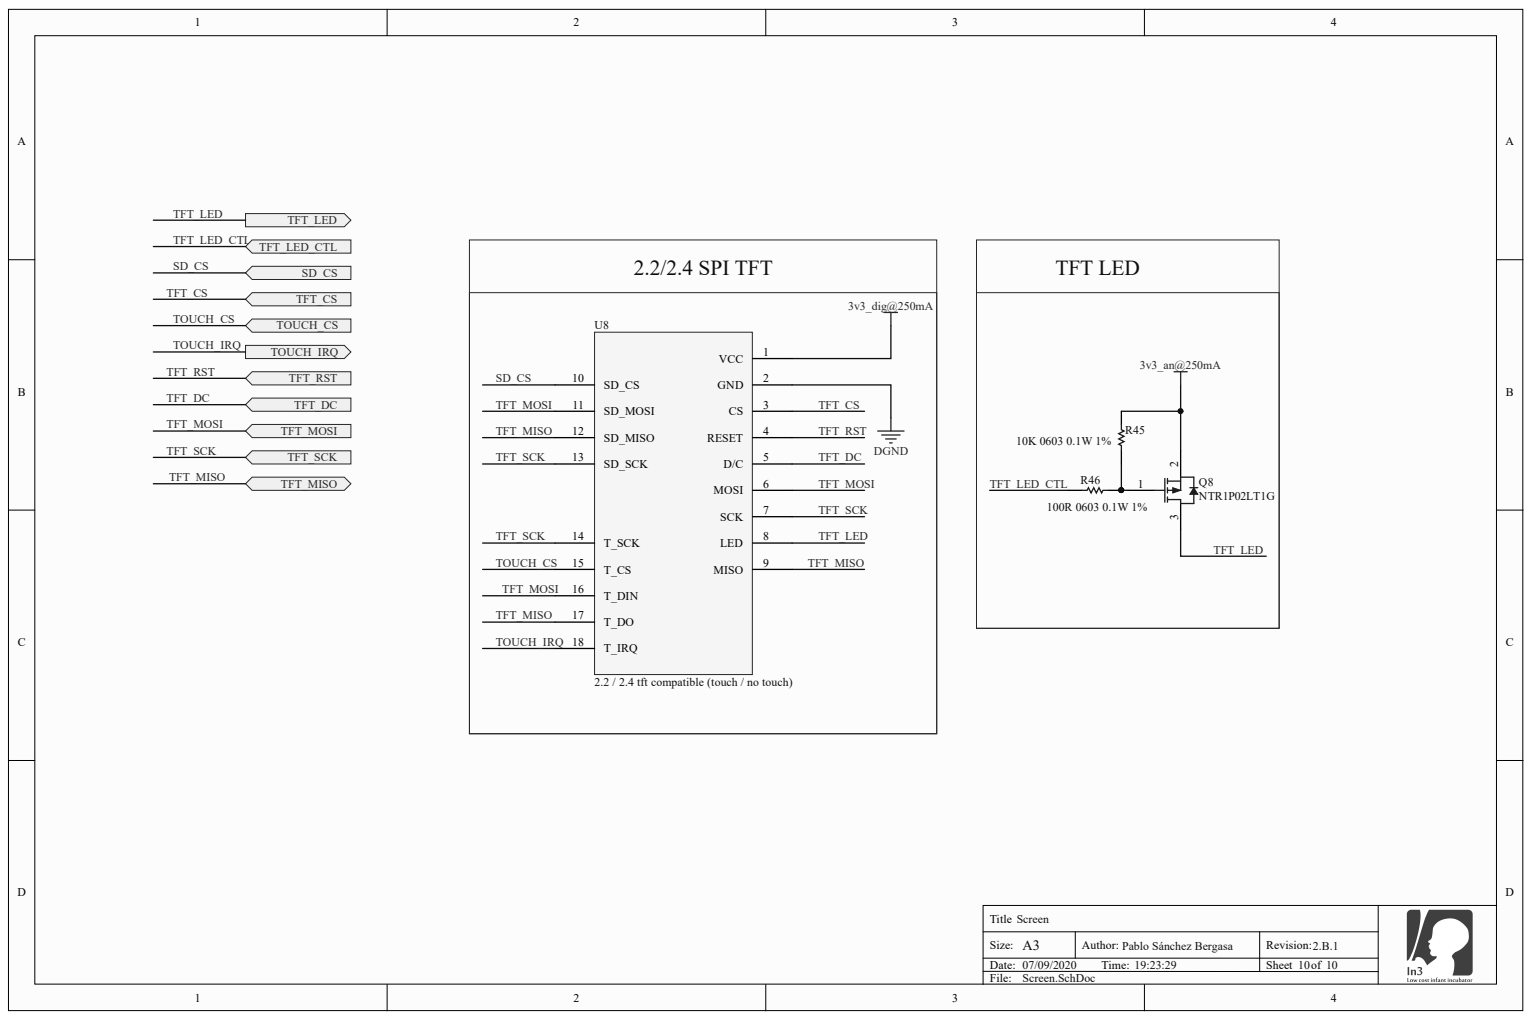
[picture p11: page 11]
2.2/2.4 SPI TFT; TFT LED; TFT_LED_CTL TFT_LED_CTL; SD_MISO 12; T_DIN 16; tft compat; ible (touch

T i t l e Screen

Size: A3 | Author: Pablo S ánchez Bergasa | Revision: 2. B . 1

T i me: | | Sheet of

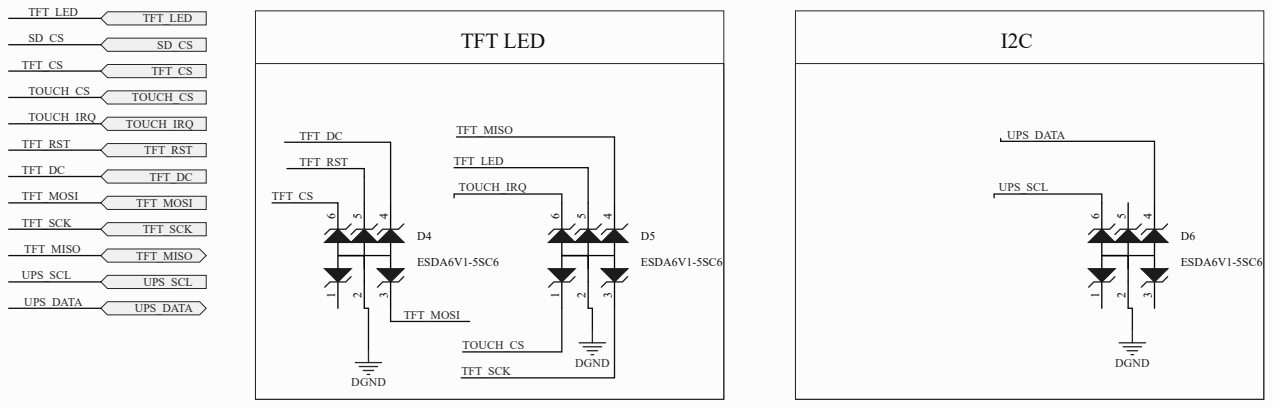
[picture p12: page 12]
Date:; Sheet of; TFT LED; TFT_LED; TFT_LED UPS_SCL UPS_DATA; UPS_DATA UPS_SCL; PID401 PID402 PID403; PID406 PID405 PID404; PID501 PID502 PID503; PID506 PID505 PID504; PID601 PID602 PID603; PID606 PID605 PID604; PID401 PID402; PID502

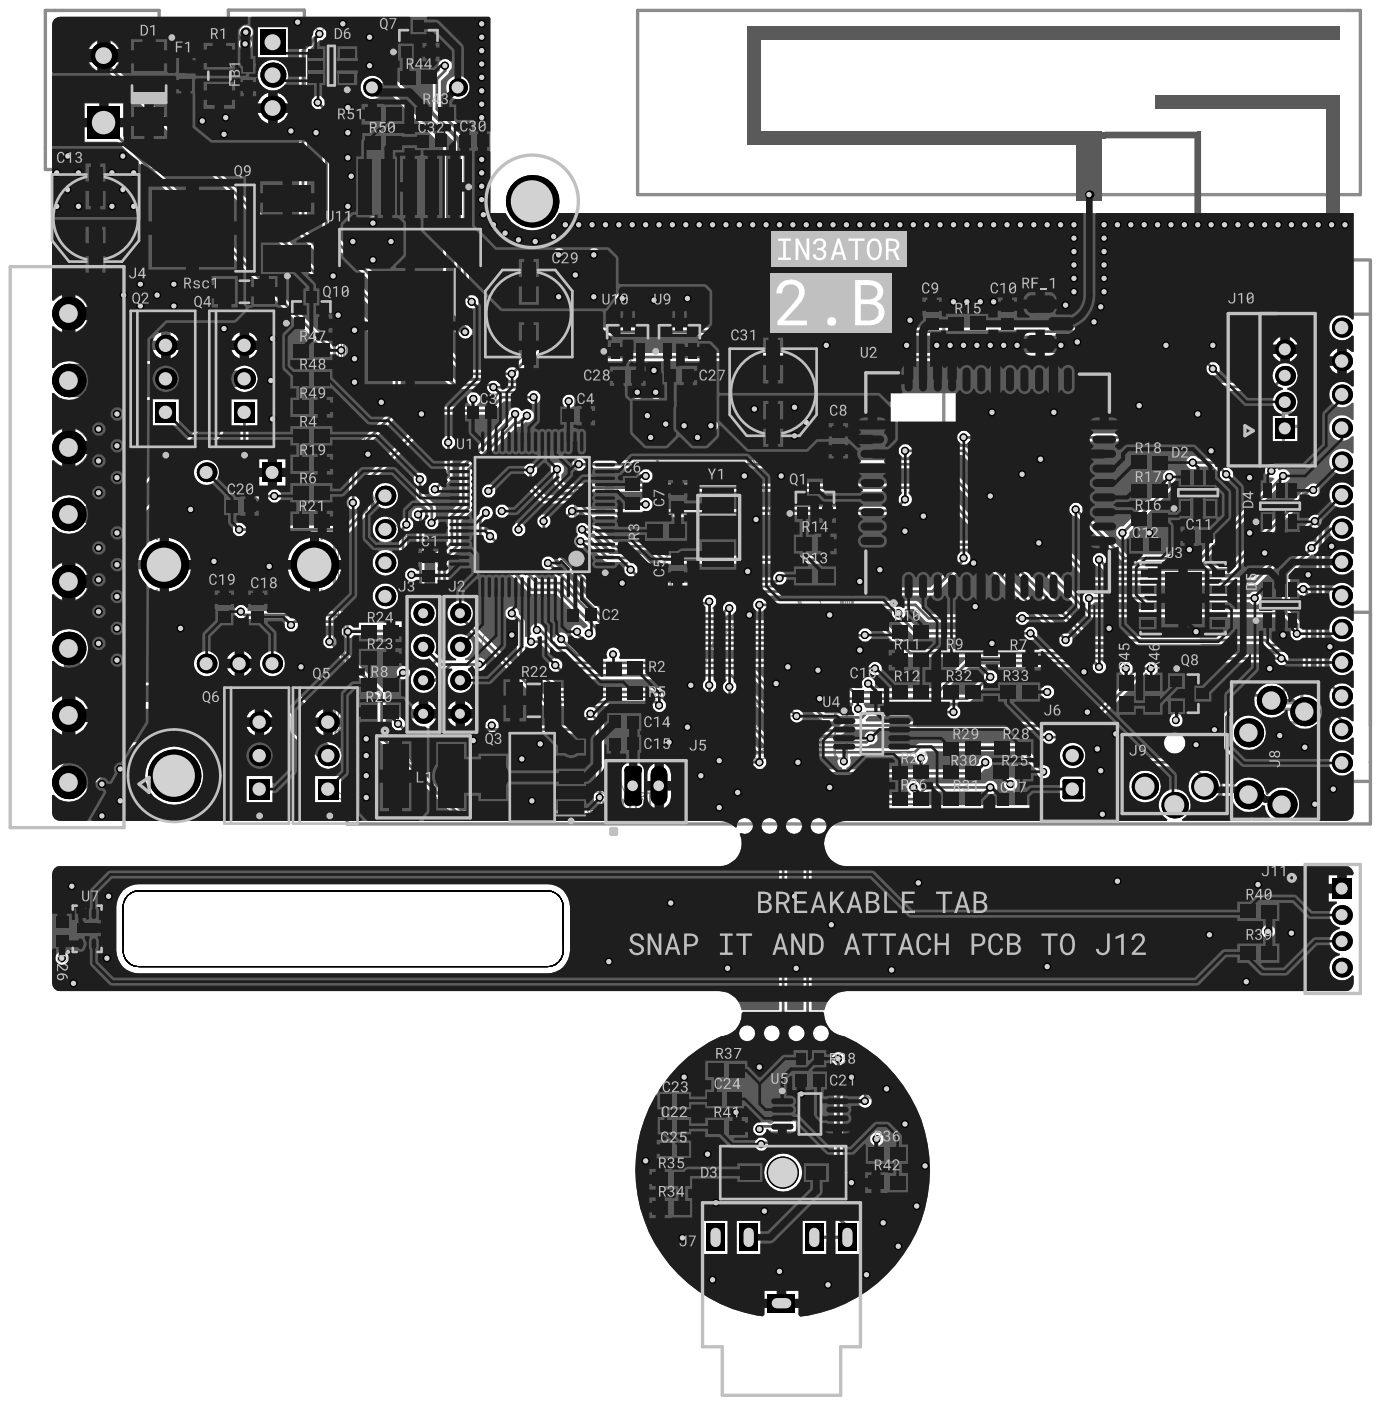
[picture p13: page 13]

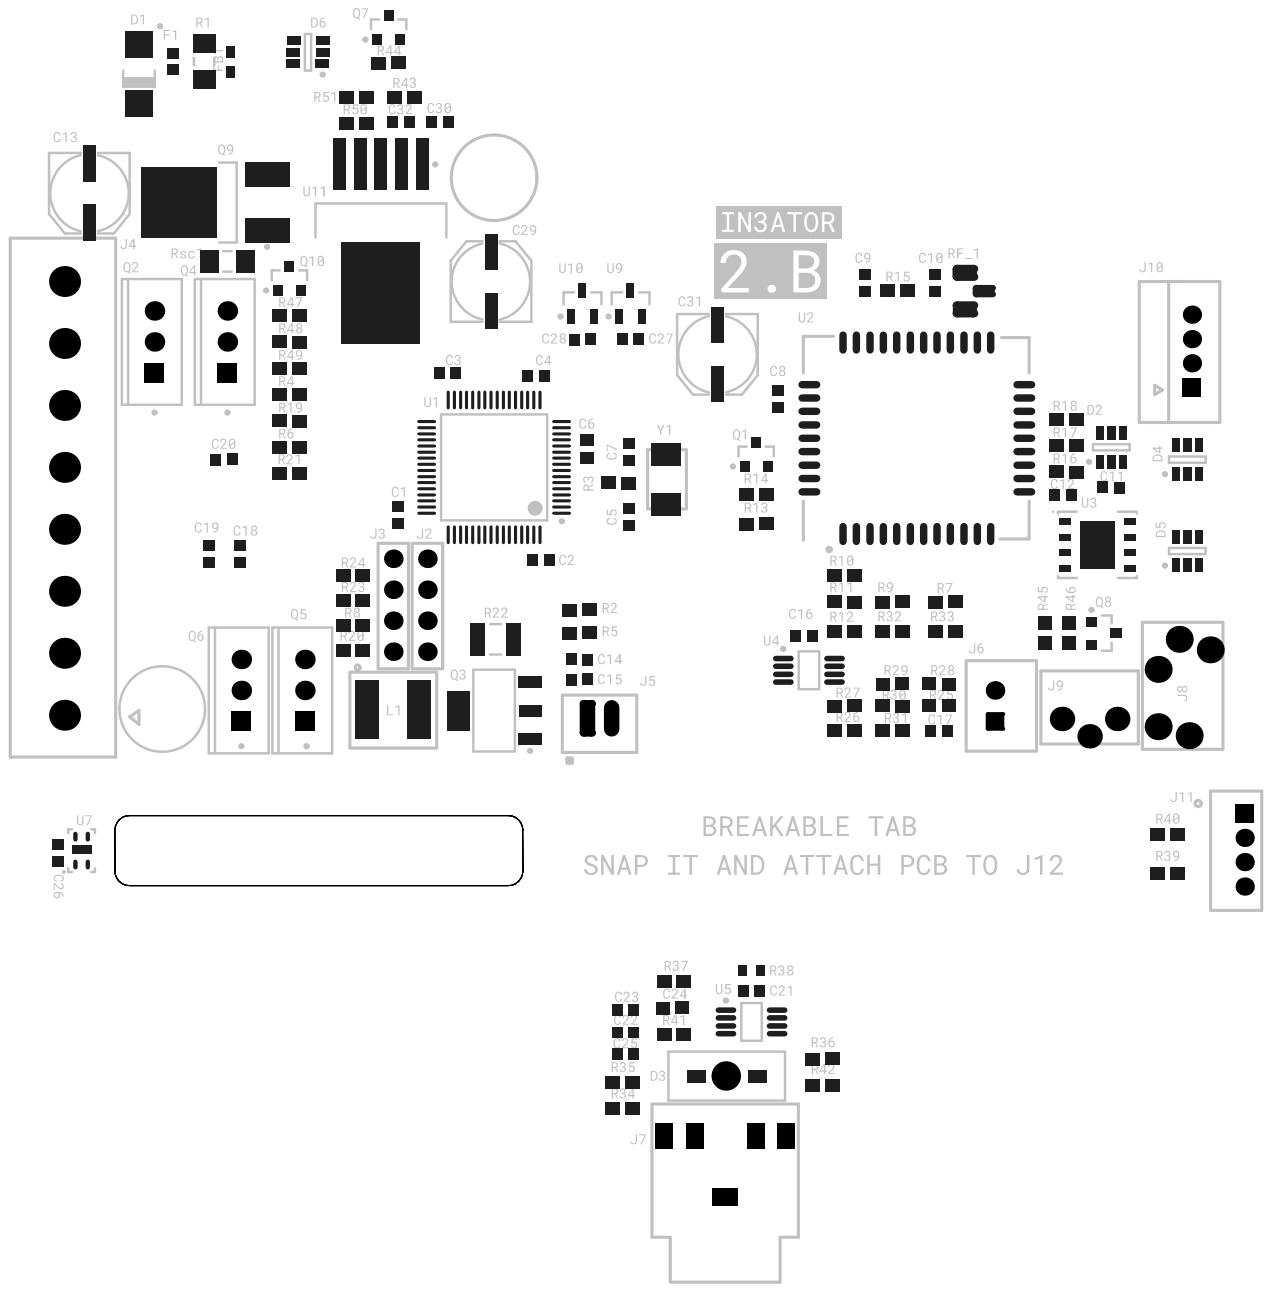
[picture p14: page 15]

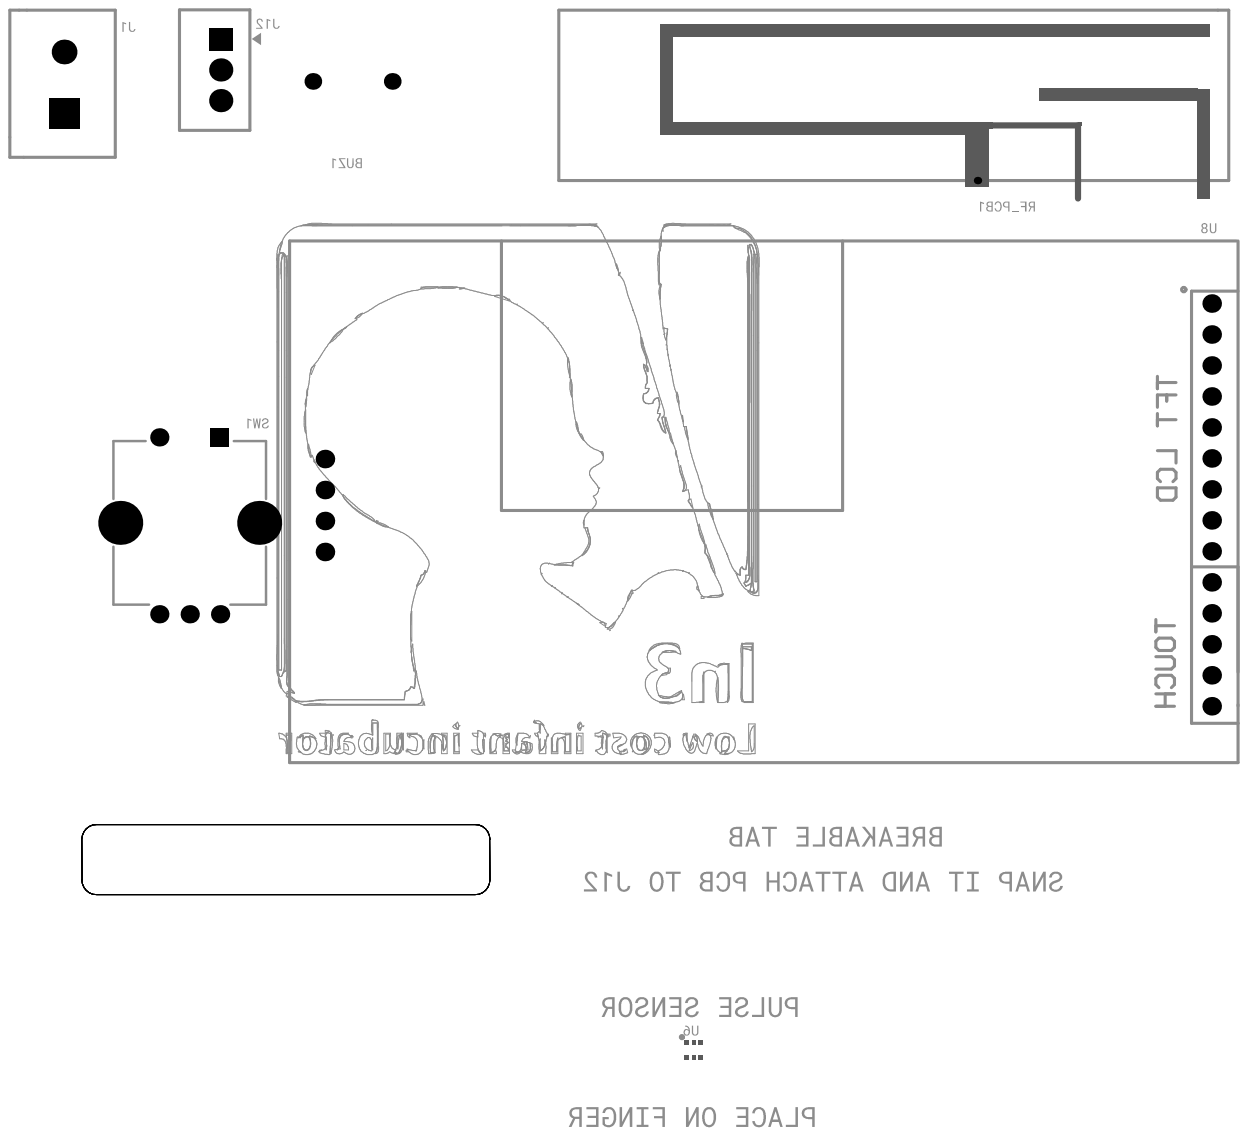
[picture p15: page 16]
