pablo18393/in3ator/IN3_hardware/V6/Released/in3ator.PDF

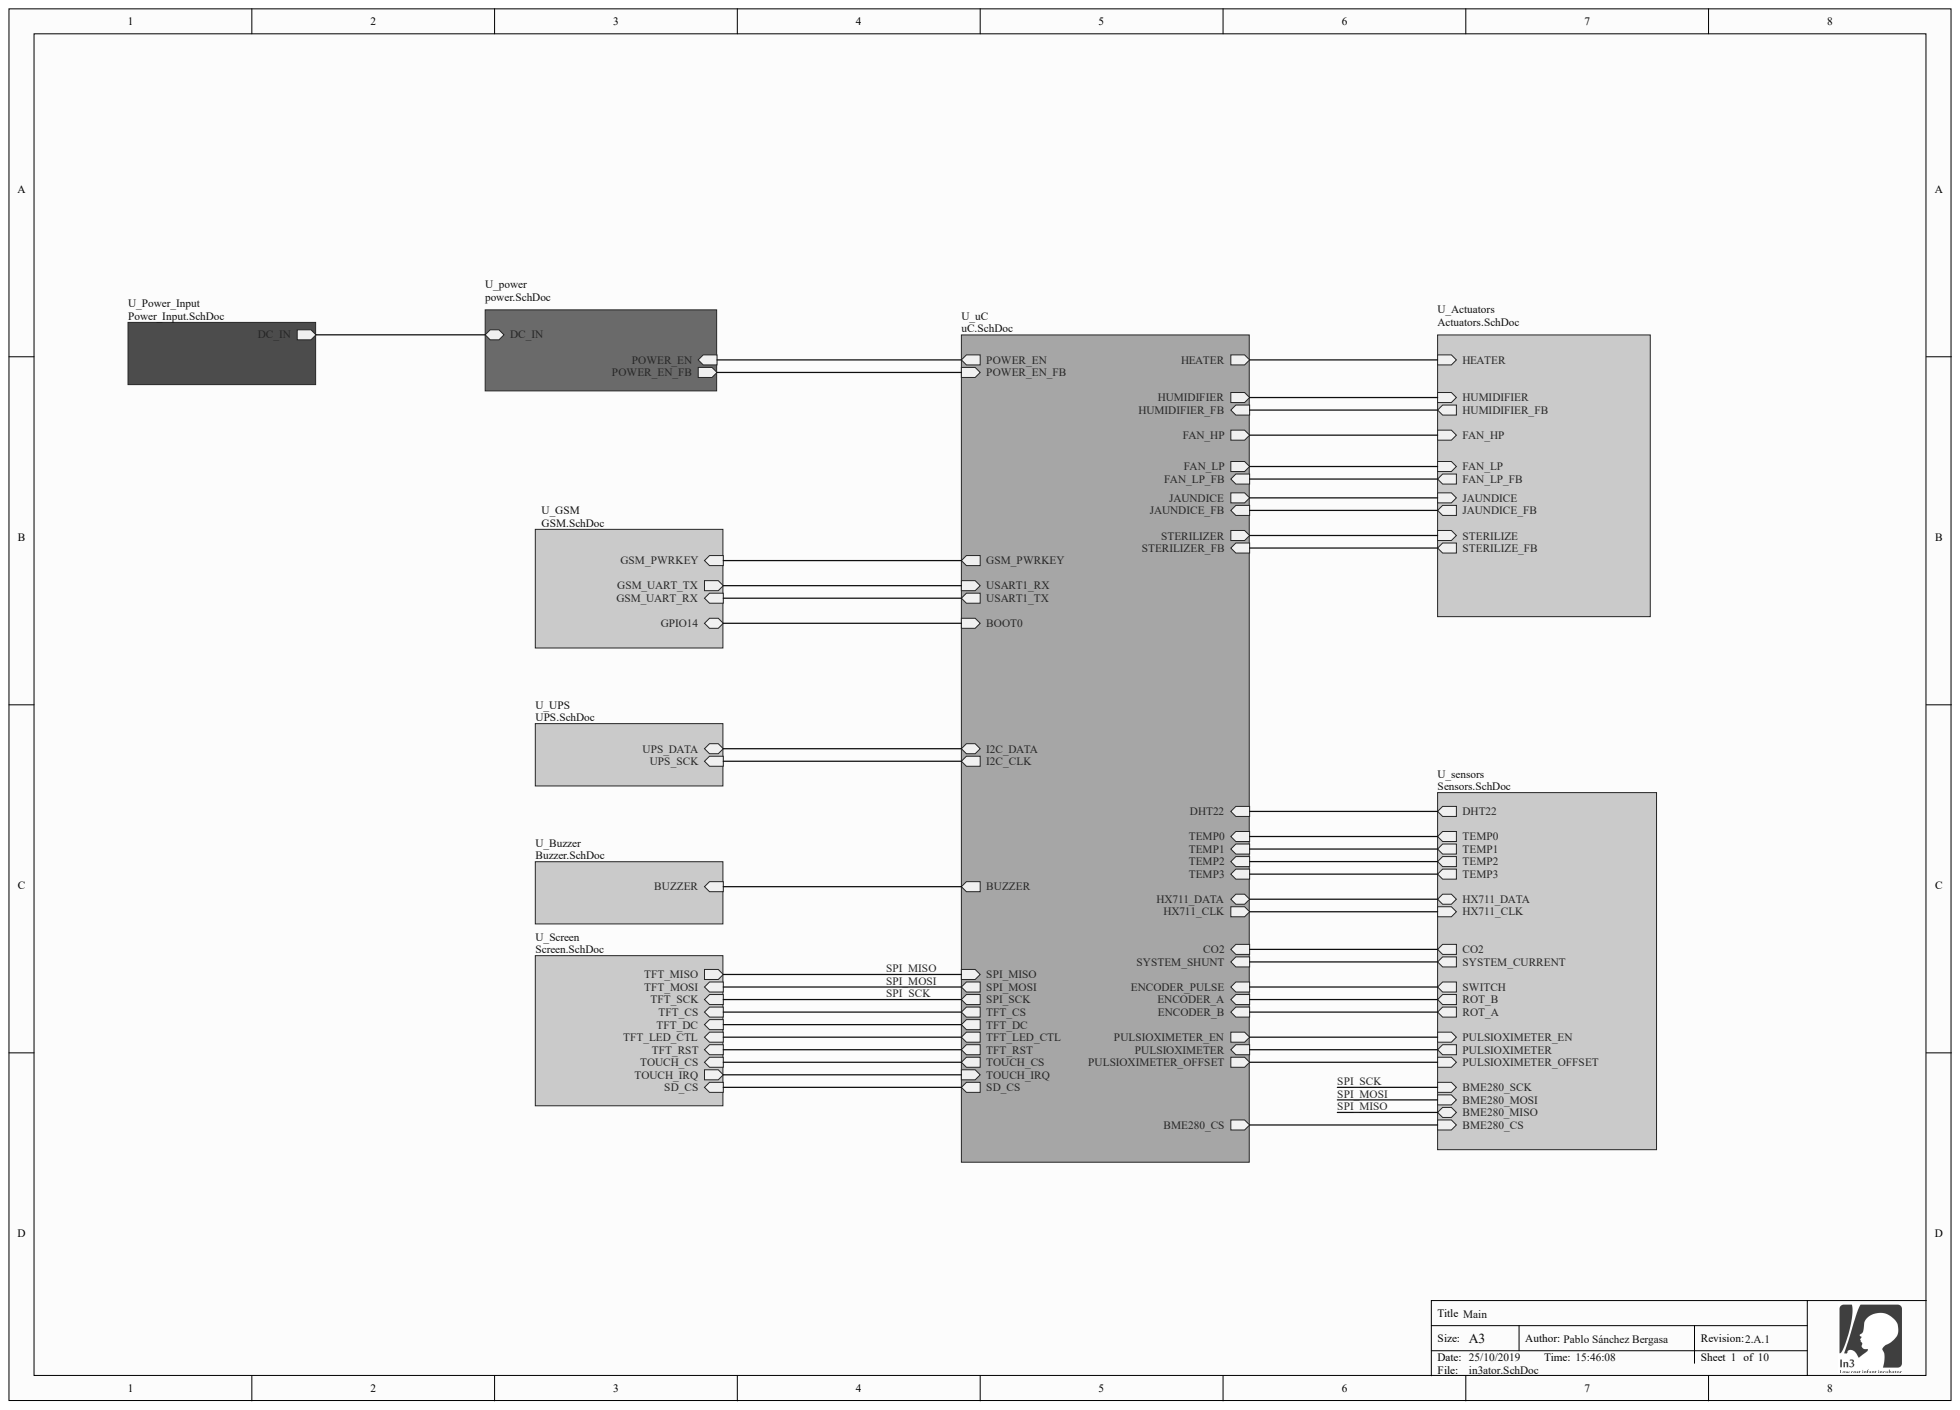
[picture p16: page 1]
uC.SchDoc DC_IN

Title Main

Size: A3 | Author: Pablo Sánchez Bergasa | Revision: 2.A.1

File: in3ator.SchDoc

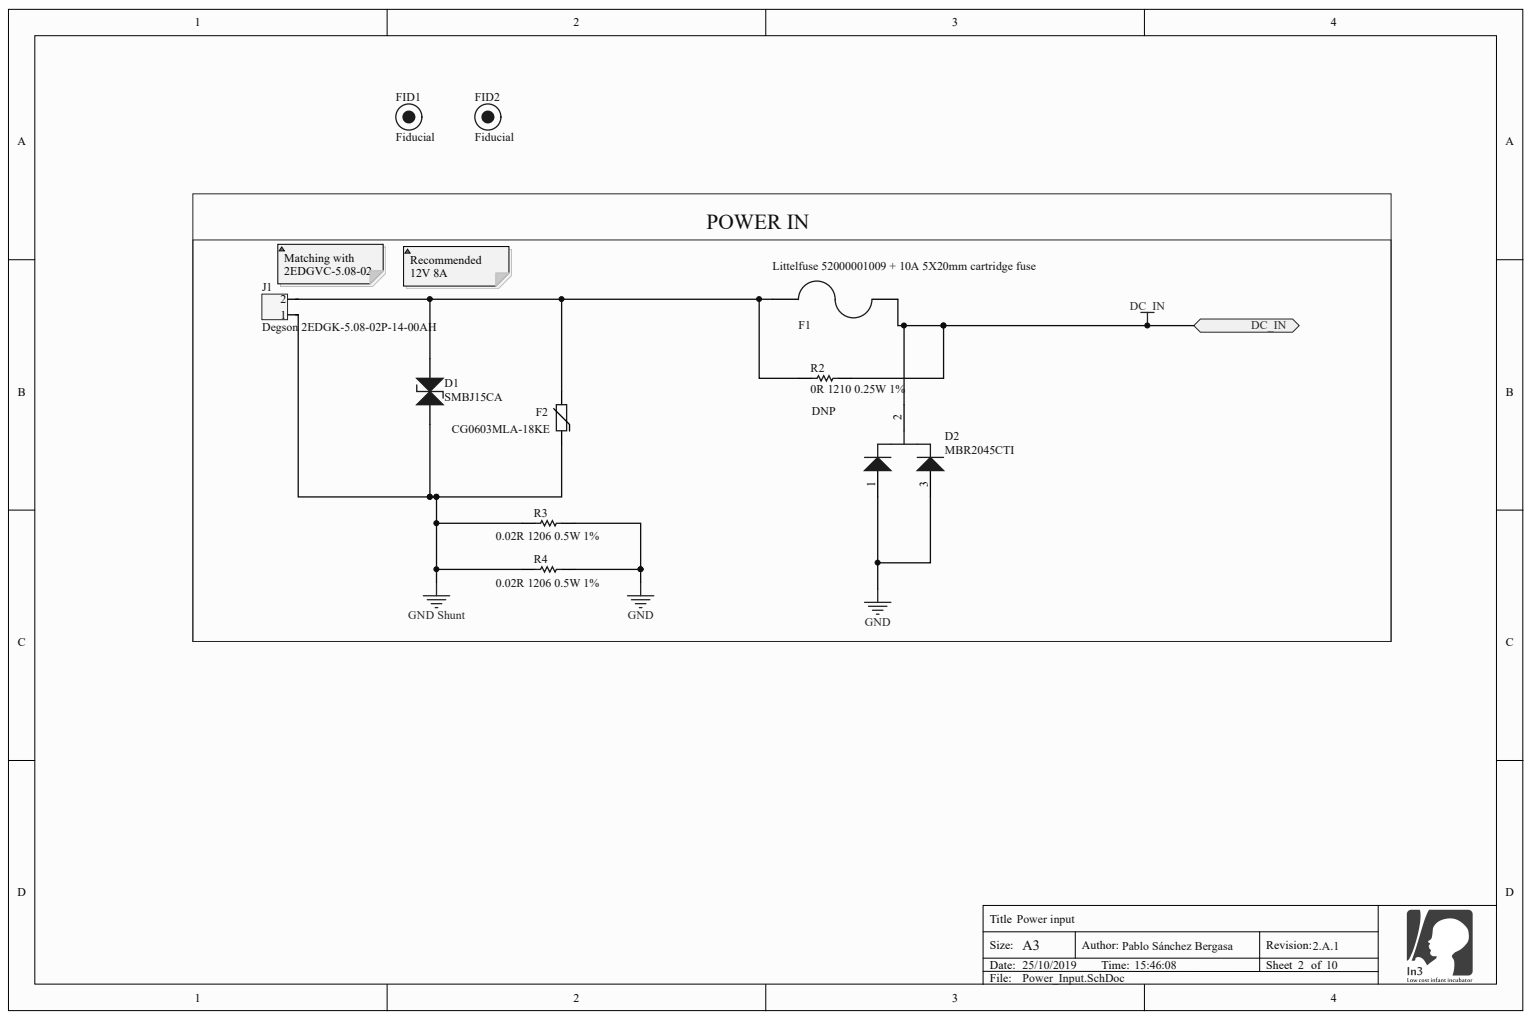
[picture p17: page 2]
POWER IN; GND Shunt; GND; Degson 2EDGK-5.08-02P-14-00AH; Matching with

Littelfuse 52000001009 + 10A 5X20mm cartridge fuse

Title Power input

Size: A3 | Author: Pablo Sánchez Bergasa | Revision: 2.A.1

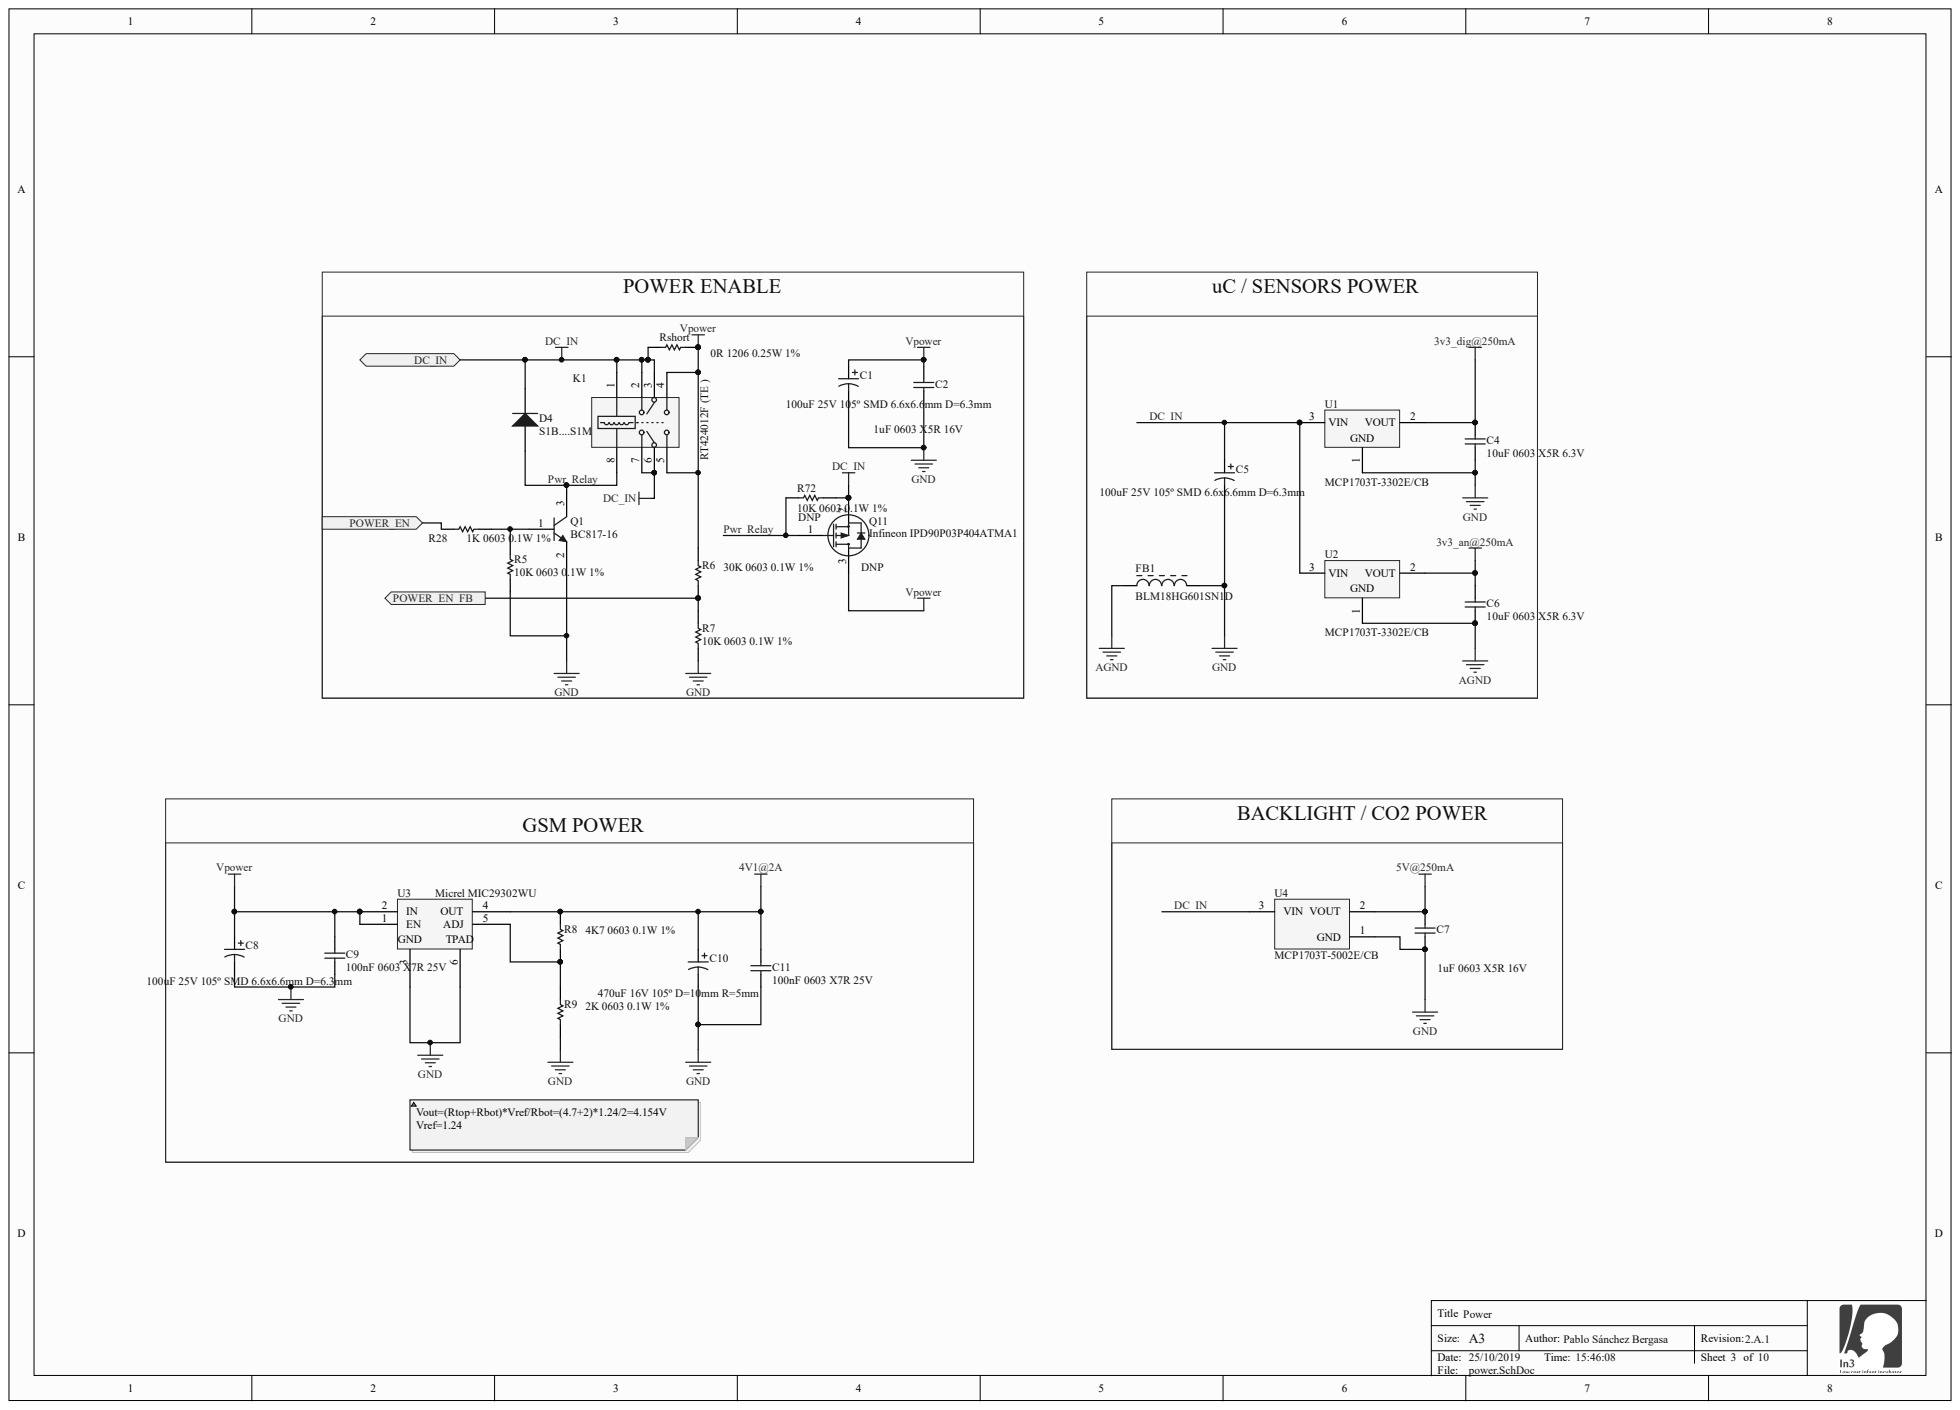
[picture p18: page 3]

Vout=(Rtop+Rbot)*Vref/Rbot=(4.7+2)*1.24/2=4.154V
Vref=1.24

Title Power

Size: A3 | Author: Pablo Sánchez Bergasa | Revision: 2.A.1

power.SchDoc

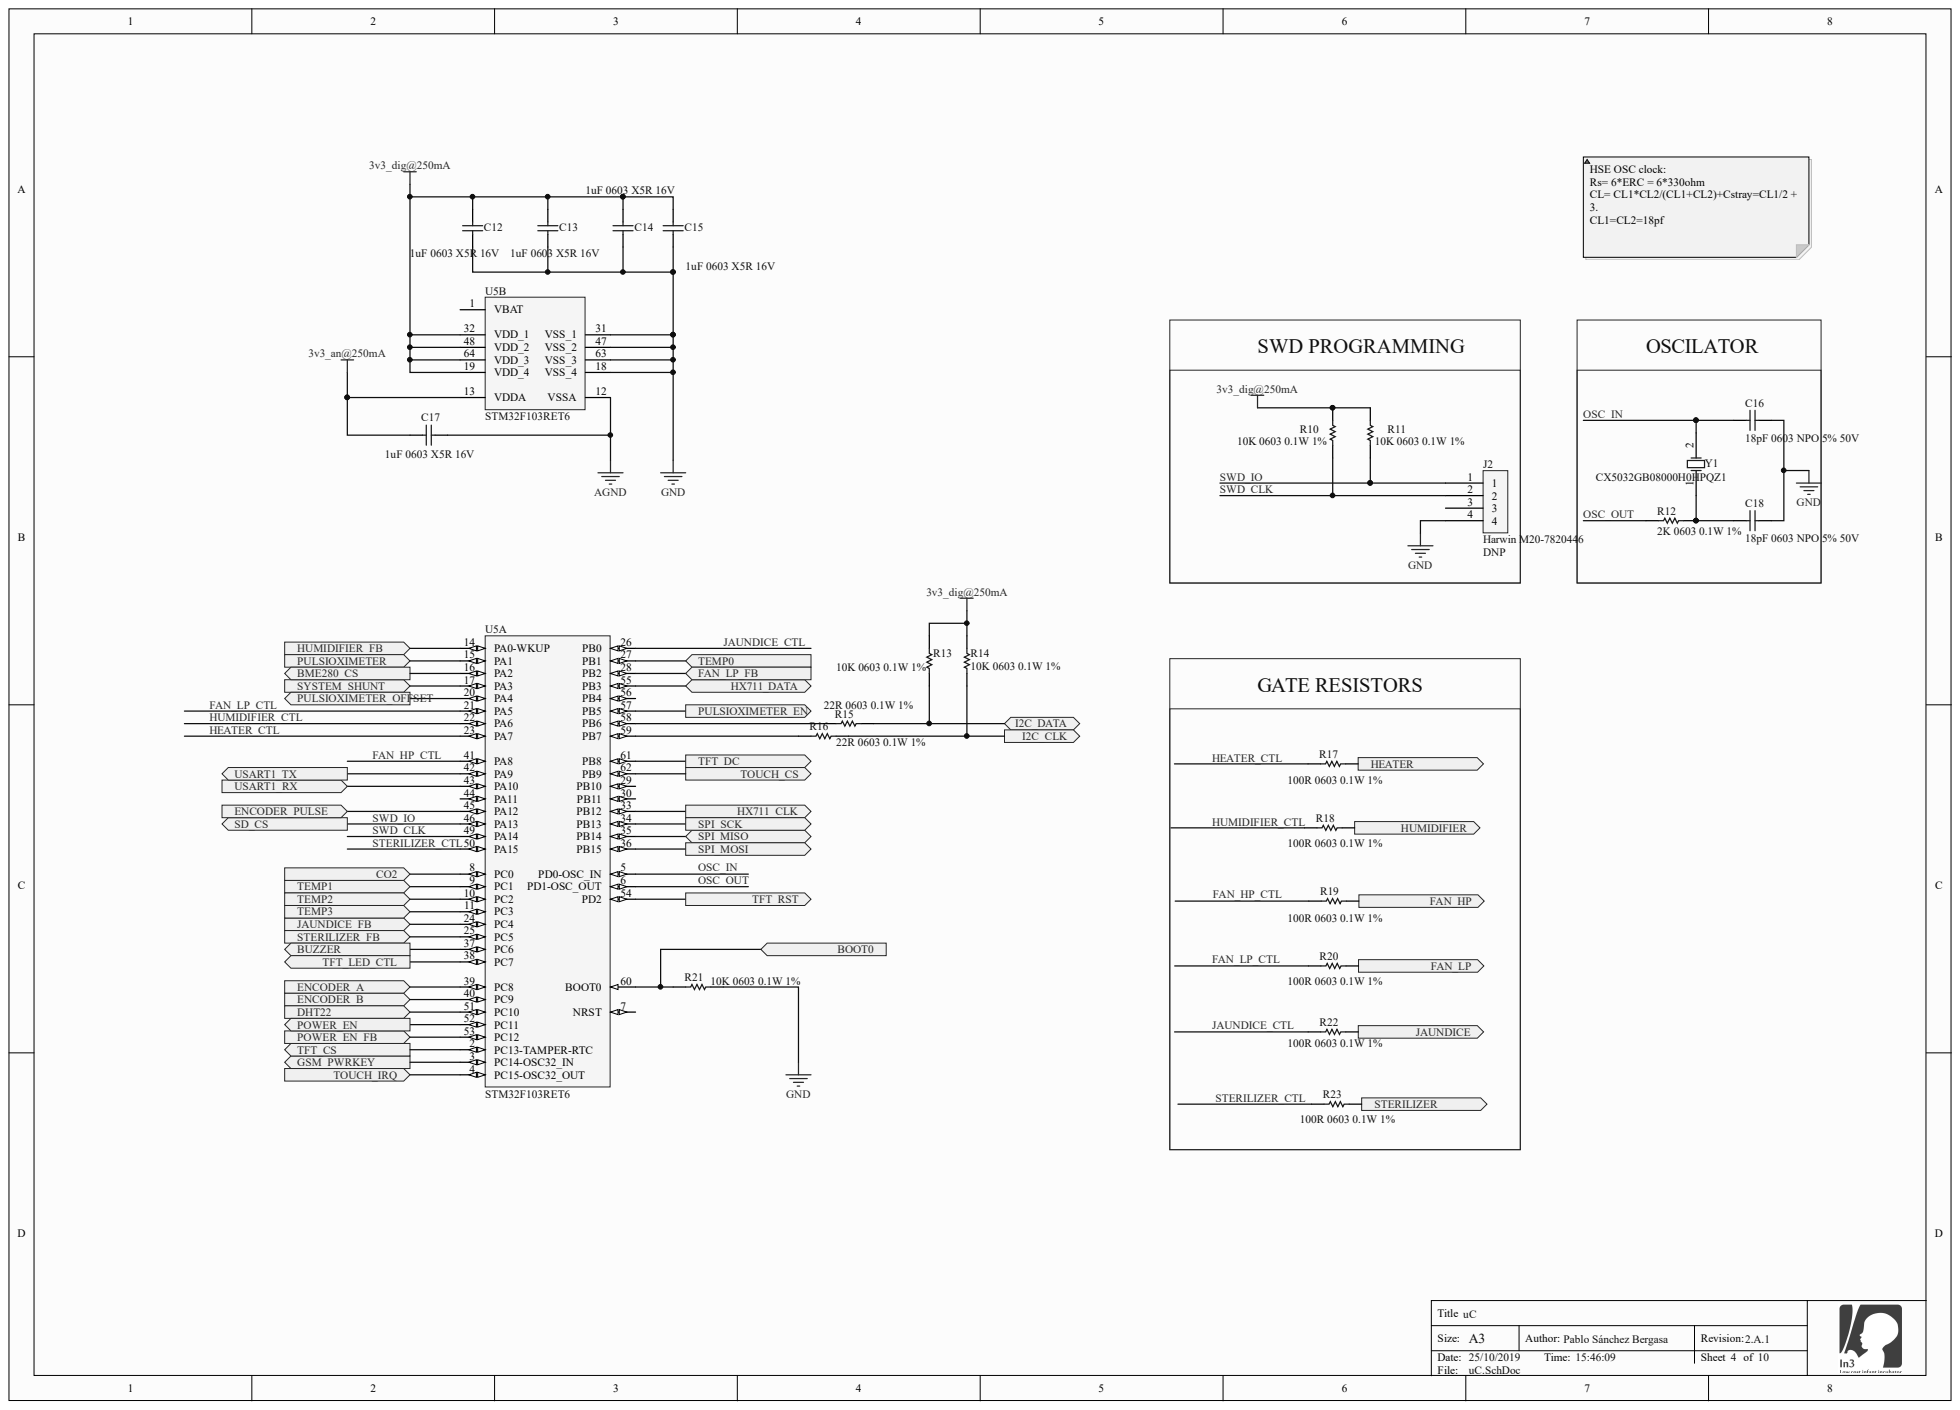
[picture p19: page 4]

Title uC

Size: A3 | Author: Pablo Sánchez Bergasa | Revision: 2.A.1

uC.SchDoc

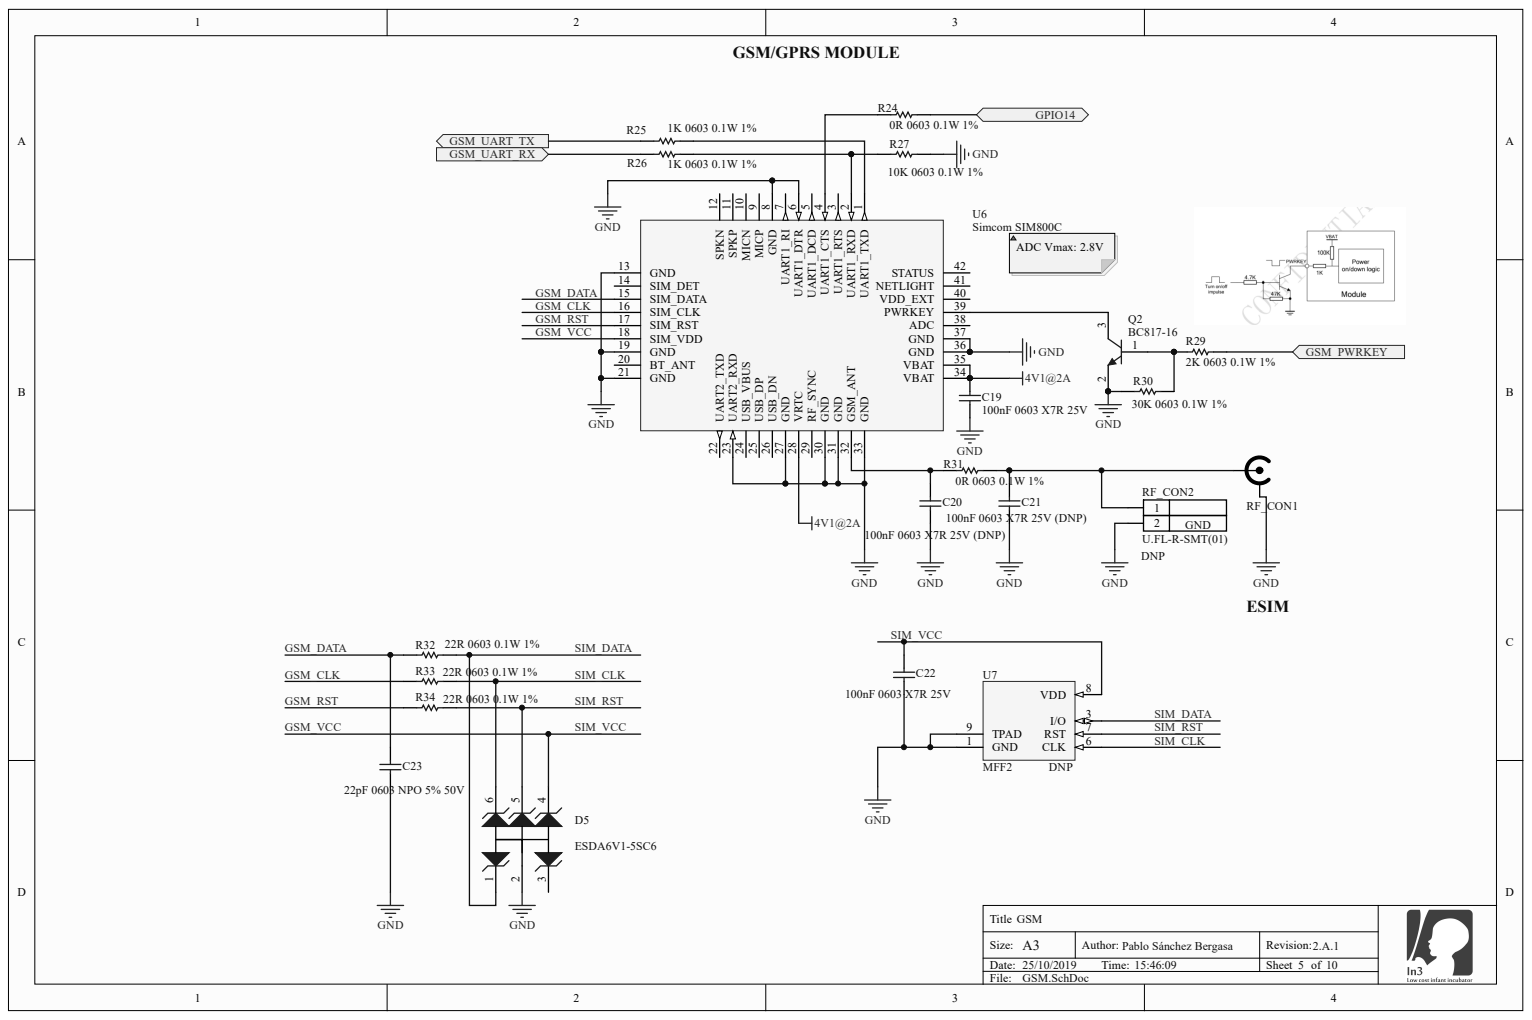
[picture p20: page 5]

SIM_DET 14

SIM_CLK 16
SIM_RST 17
SIM_VDD 18
GND 19
BT_ANT 20

2 | GND

Title GSM

Size: A3 | Author: Pablo Sánchez Bergasa | Revision: 2.A.1

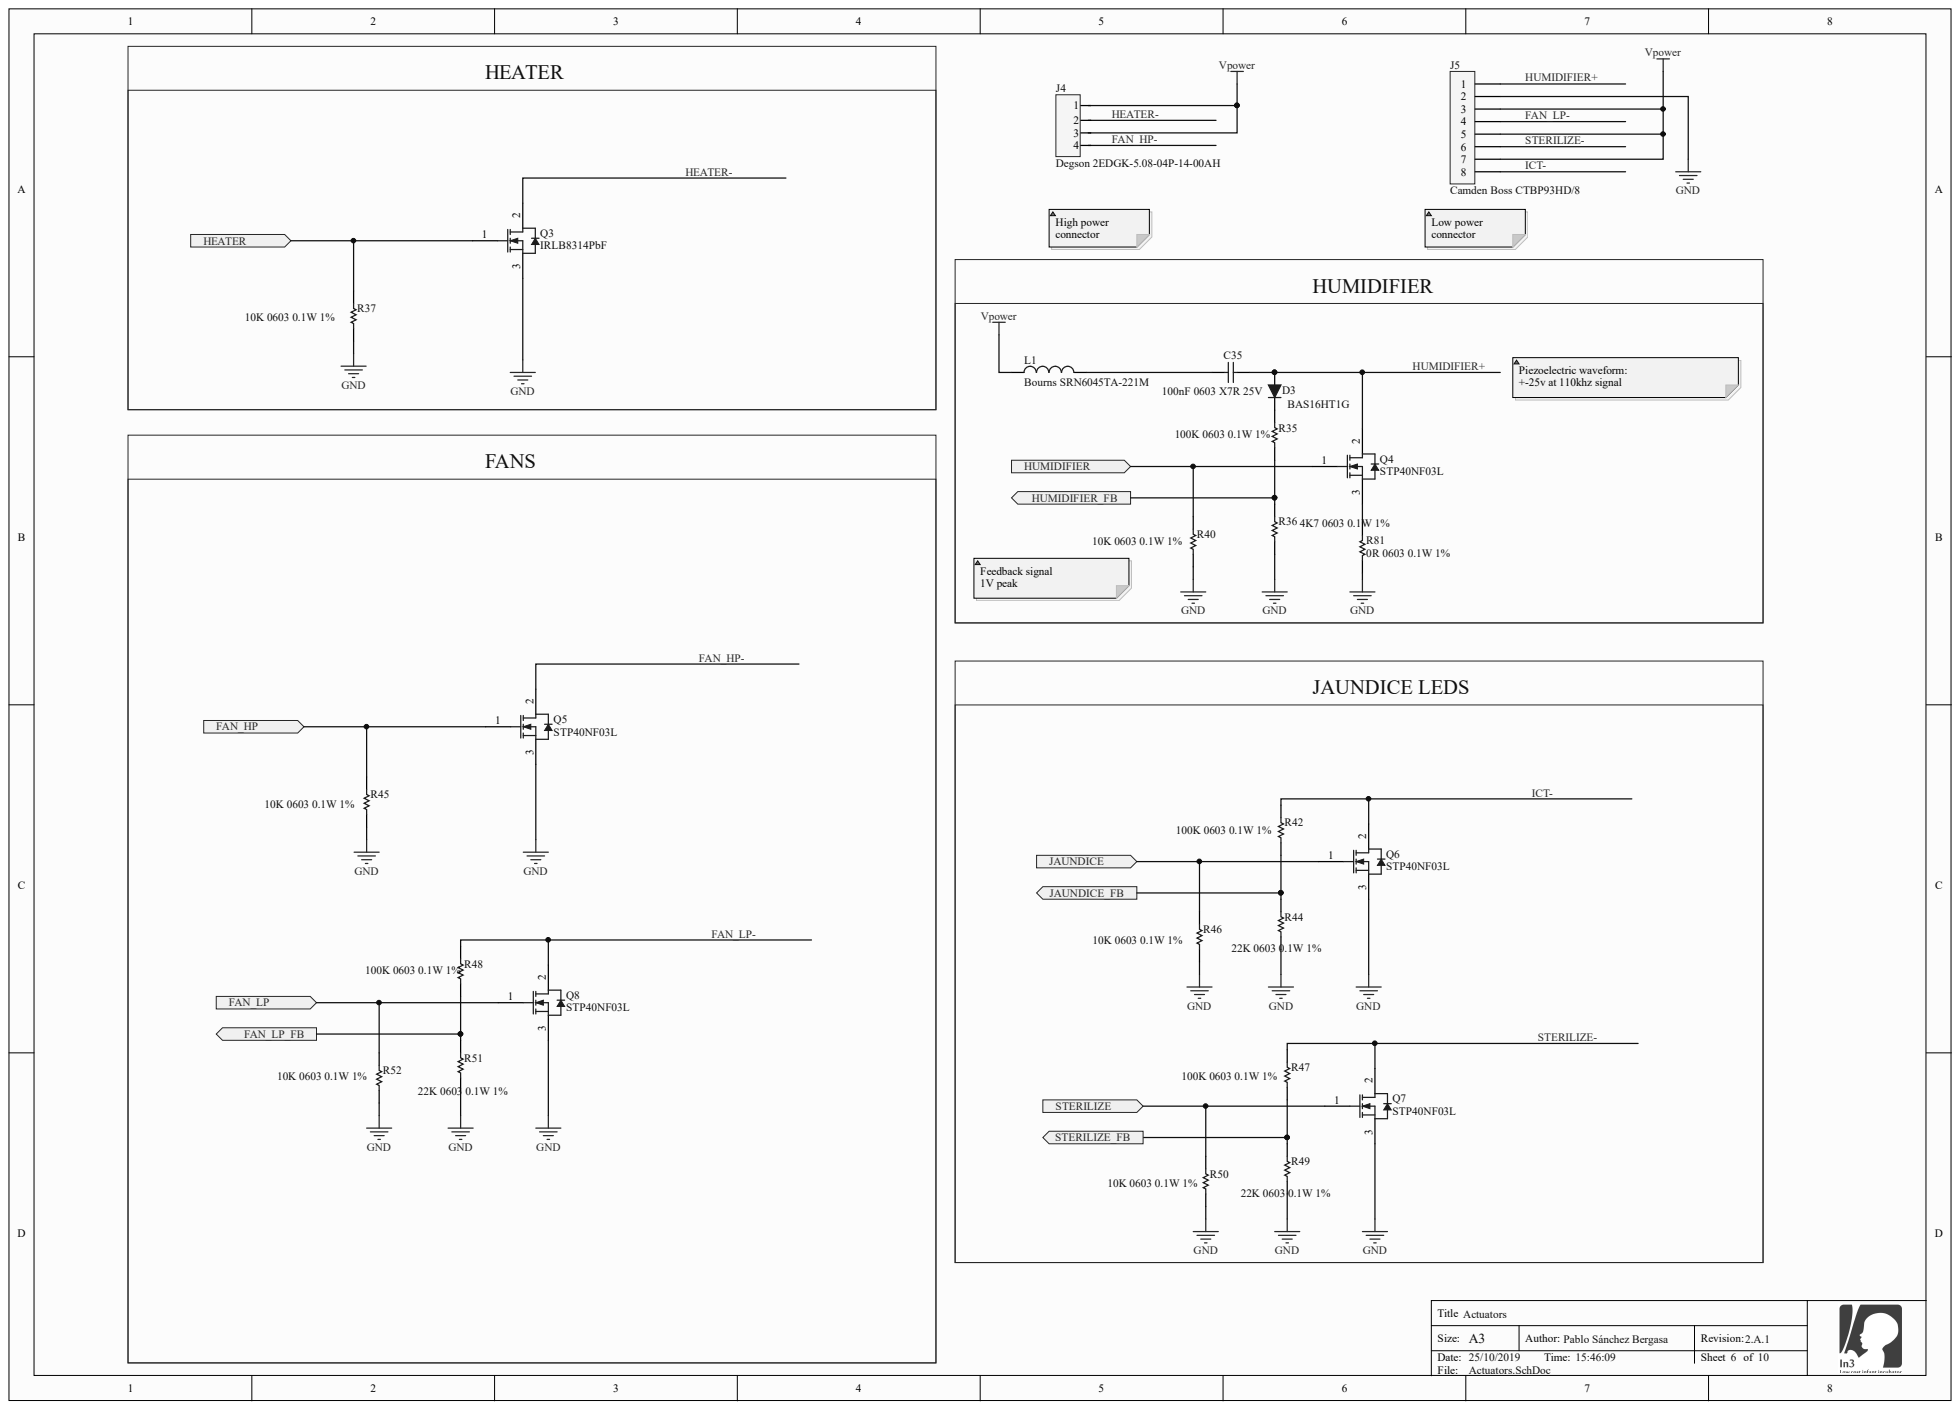
[picture p21: page 6]

Actuator s

A | : P ablo S ánche z B e rgasa | R evision: 2.A.1

File : Actuators.S chDoc

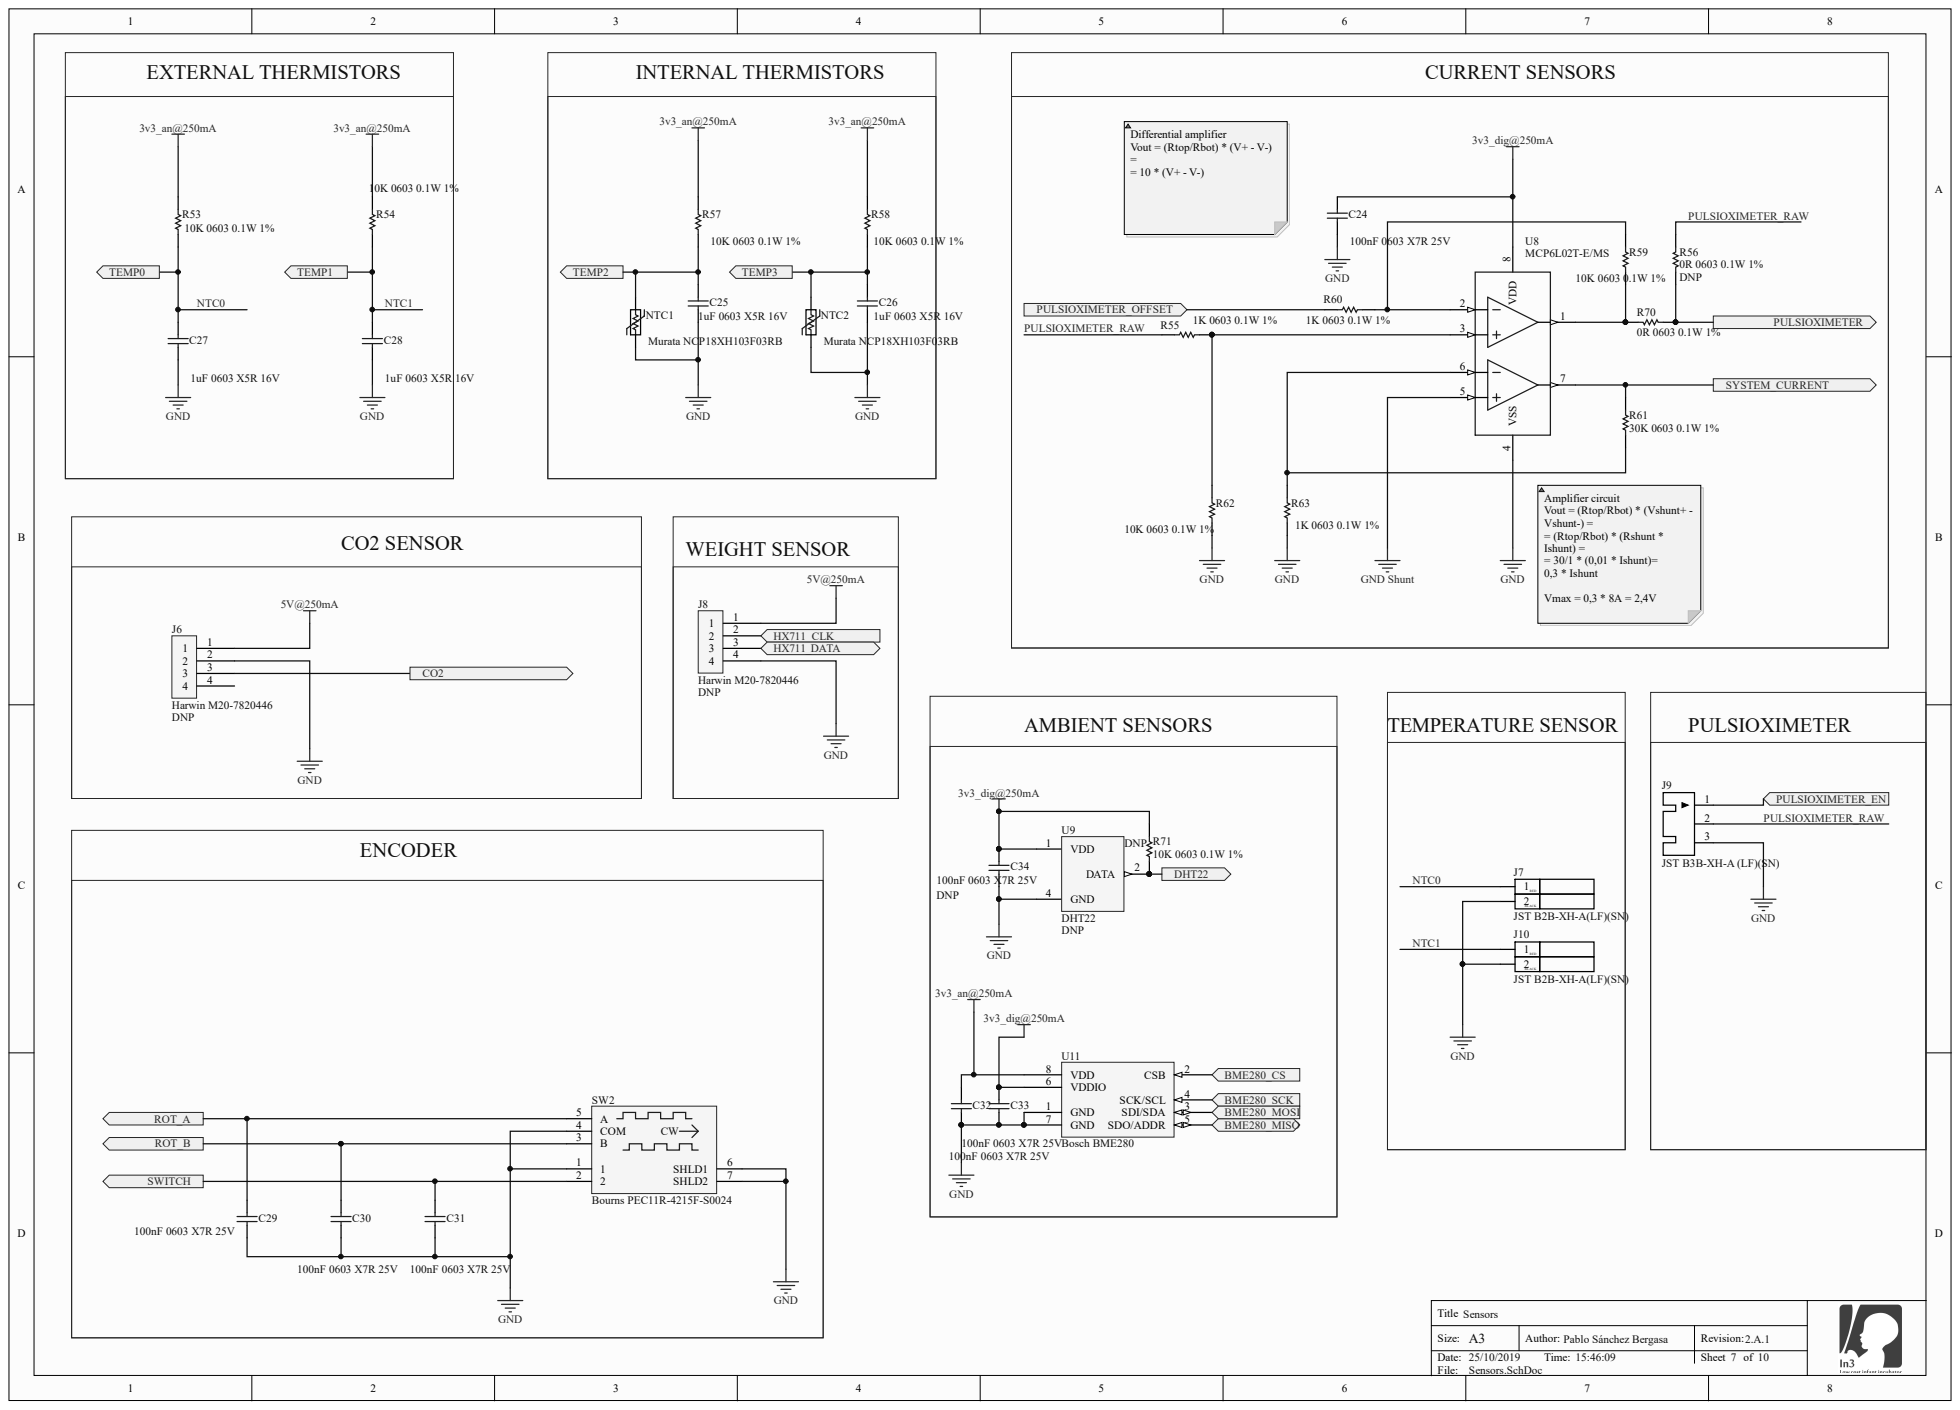
[picture p22: page 7]

C34 | GND 4

JST B3B-XH-A (LF)(SN)

2 BLACK

JST B2B-XH-A(LF)(SN)

1 RED

Title Sensors

Size: A3 | Author: Pablo Sánchez Bergasa | Revision: 2.A.1

Sensors.SchDoc

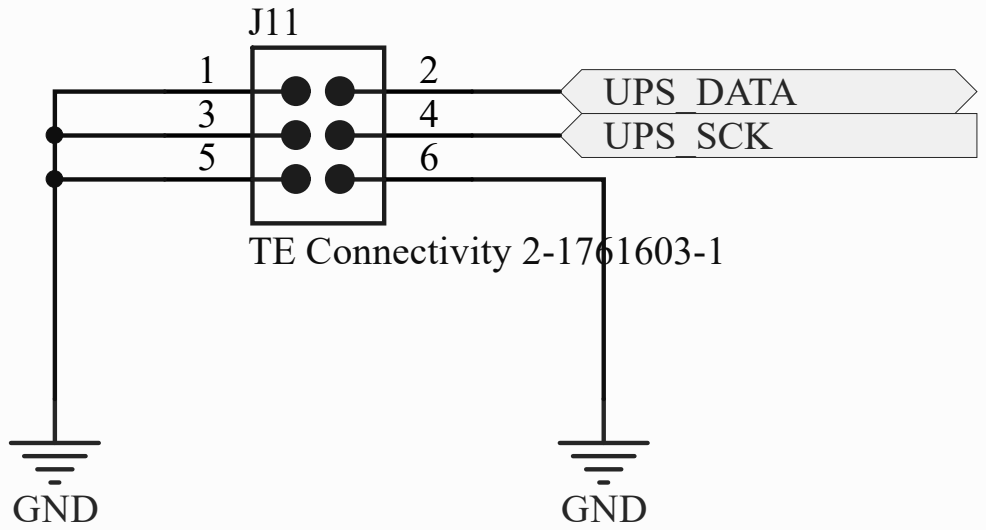
[picture p23: page 8]
TE Connectivity 2-1761603-1; PIJ1102; POUPS0DATA PIJ1104; POUPS0SCK

Title UPS

Size: A3 | Author: Pablo Sánchez Bergasa | Revision: 2.A.1

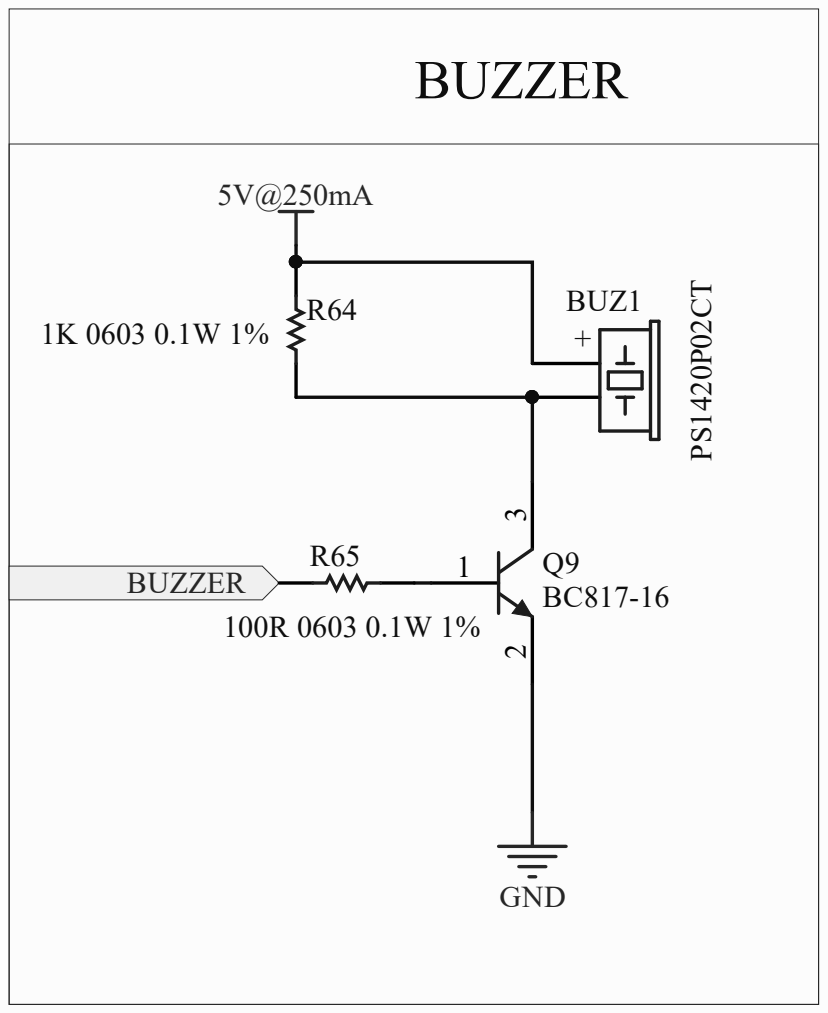
[picture p24: page 9]

Title Buzzer

Size: A3 | Author: Pablo Sánchez Bergasa | Revision: 2.A.1

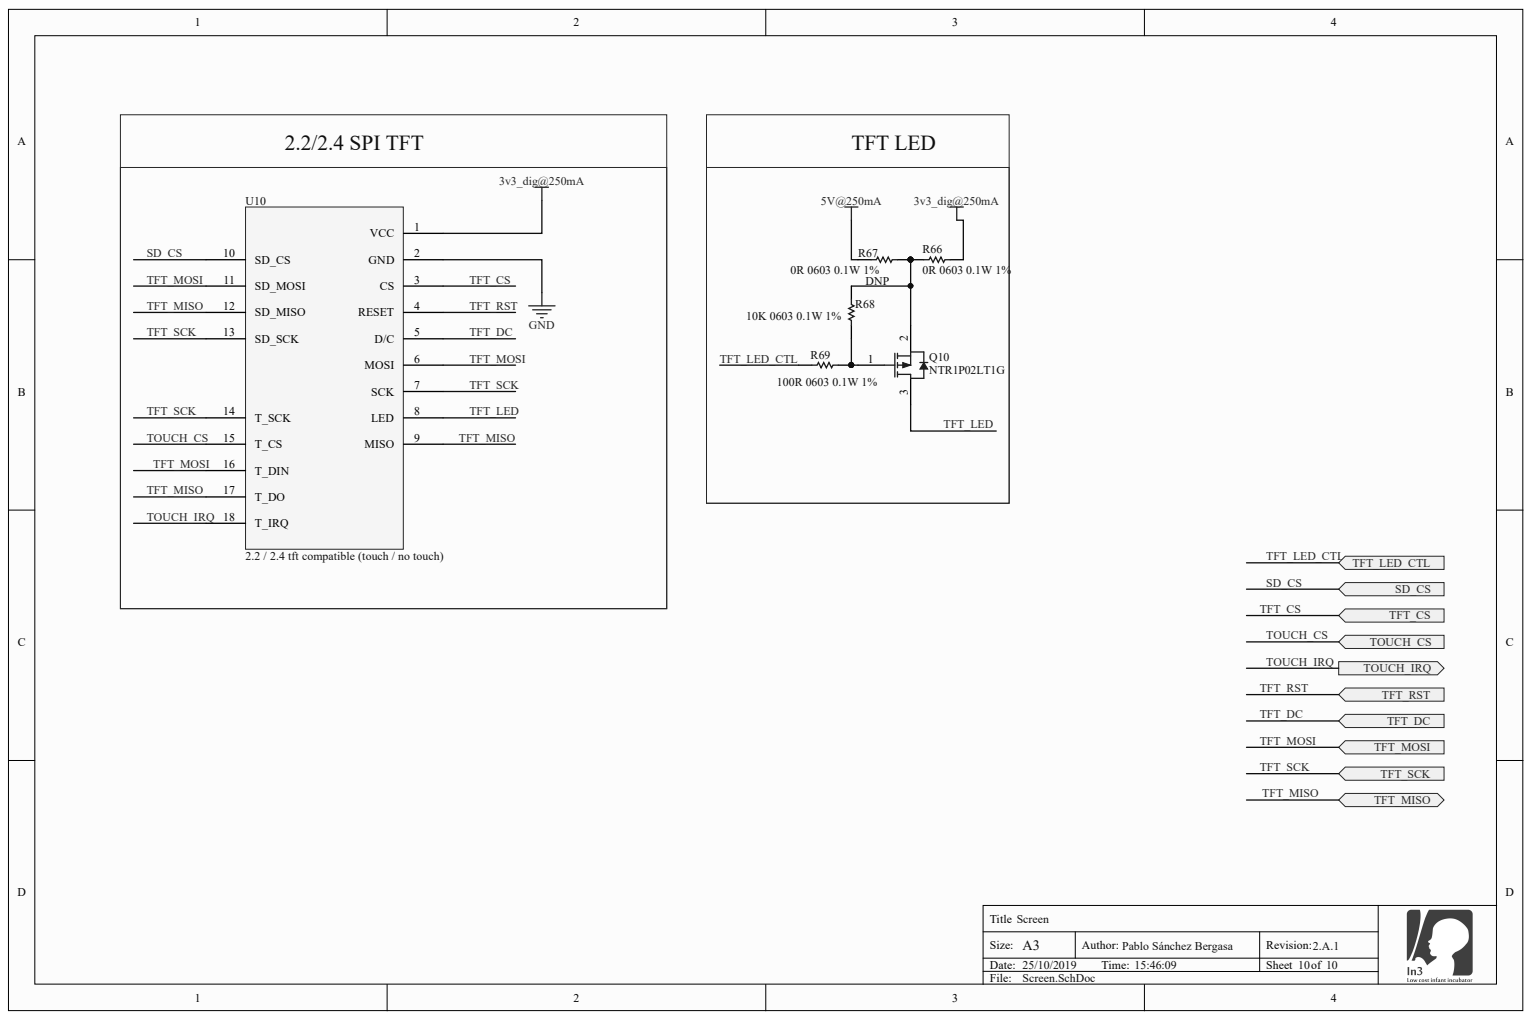
[picture p25: page 10]
2.2/2.4 SPI TFT; TFT LED; TFT_LED_CTL TFT_LED_CTL; SD_MISO 12; T_DIN 16; tft compat; ible (touch; Q10 NTR1P02LT1G

T i t l e Screen

Size: A3 | Author: Pablo S ánchez Bergasa | Revision: 2. A . 1

T i me: | | Sheet of

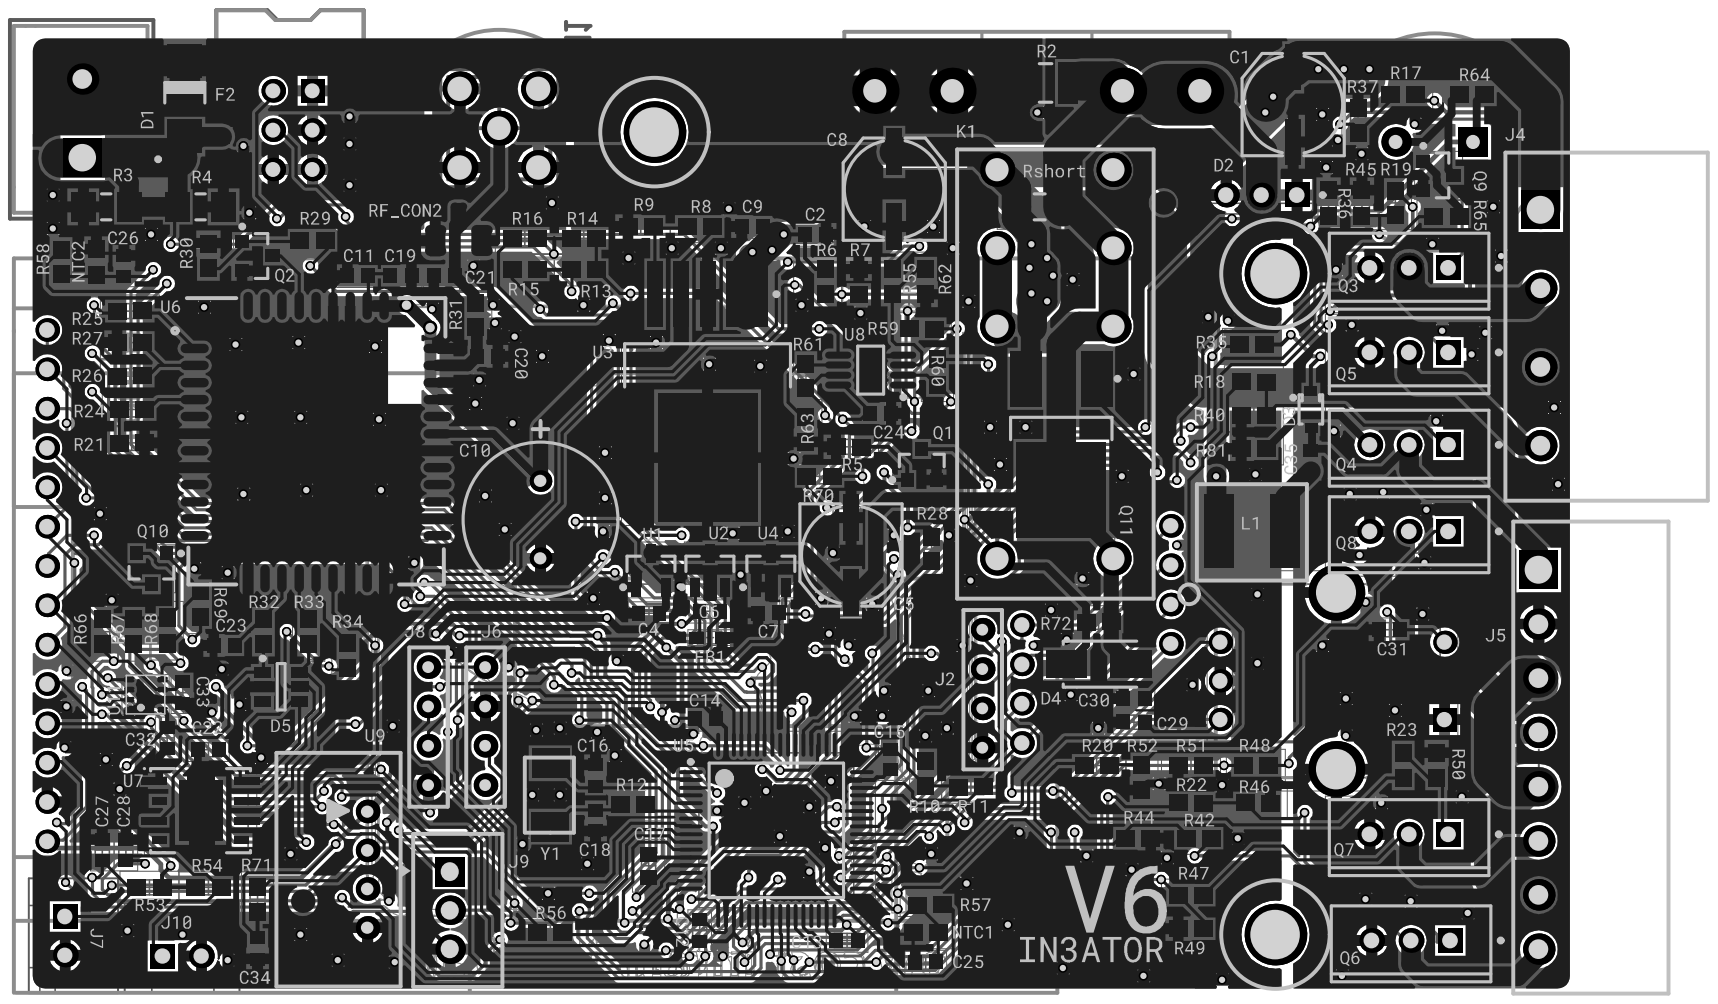
[picture p26: page 11]

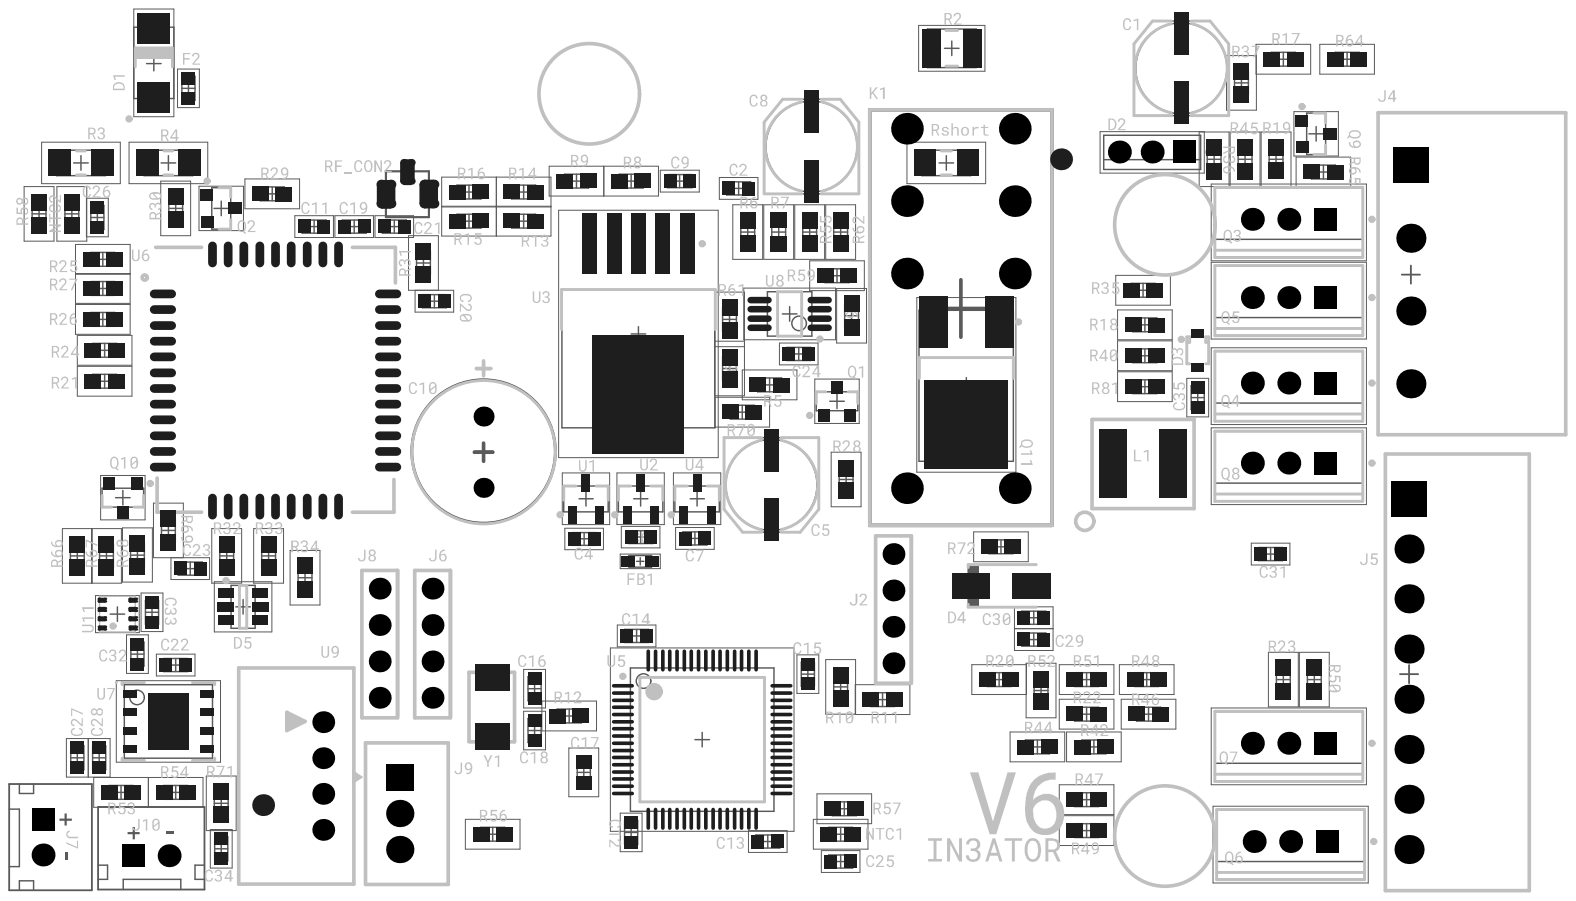
[picture p27: page 13]

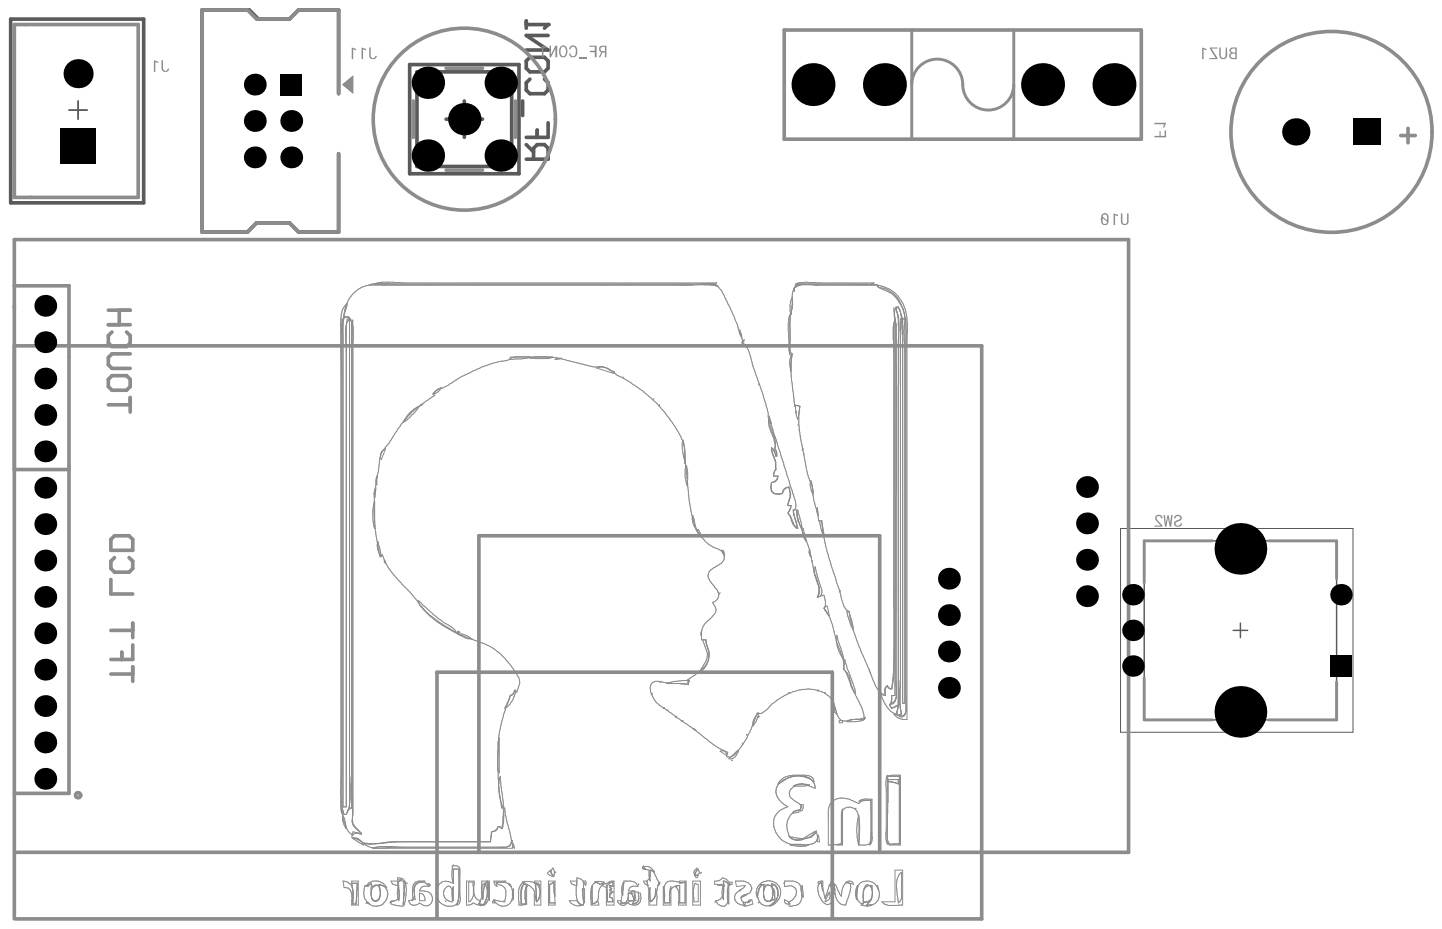
[picture p28: page 14]
