pablo18393/in3ator/(list of files, drawings)

Other design files:
IN3_hardware/V2.B/Design/Actuators.SchDoc
IN3_hardware/V2.B/Design/Buzzer.SchDoc
IN3_hardware/V2.B/Design/ESD_Protection.SchDoc
IN3_hardware/V2.B/Design/GSM.SchDoc
IN3_hardware/V2.B/Design/in3ator.PrjPcb
IN3_hardware/V2.B/Design/in3ator.SchDoc
IN3_hardware/V2.B/Design/Power_Input.SchDoc
IN3_hardware/V2.B/Design/Power_management.SchDoc
IN3_hardware/V2.B/Design/Screen.SchDoc
IN3_hardware/V2.B/Design/Sensors.SchDoc
IN3_hardware/V2.B/Design/uC.SchDoc
IN3_hardware/V2.B/Design/UPS.SchDoc
IN3_hardware/V6/Design/Actuators.SchDoc
IN3_hardware/V6/Design/Buzzer.SchDoc
IN3_hardware/V6/Design/GSM.SchDoc
IN3_hardware/V6/Design/in3ator.PrjPcb
IN3_hardware/V6/Design/in3ator.SchDoc
IN3_hardware/V6/Design/power.SchDoc
IN3_hardware/V6/Design/Power_Input.SchDoc
IN3_hardware/V6/Design/Screen.SchDoc
IN3_hardware/V6/Design/Sensors.SchDoc
IN3_hardware/V6/Design/uC.SchDoc
IN3_hardware/V6/Design/UPS.SchDoc
