pablo18393/in3ator/IN3_FW/motherBoard/source/IN3_FW/IN3_FW.ino

/*
  MIT License

  Copyright (c) 2022 Medical Open World, Pablo Sánchez Bergasa

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
*/

//Firmware version and head title of UI screen
#define FWversion "v10.3/9.C"
#define headingTitle "in3ator"

#include <esp_task_wdt.h>
#include <WiFi.h>
#include <WiFiClient.h>
#include <WebServer.h>
#include <ESPmDNS.h>
#include <Update.h>
//include libraries
#include "SPI.h"
#include "Adafruit_GFX.h"
#include "Adafruit_ILI9341.h"
#include <EEPROM.h>
#include <SPI.h>
#include <PID_v1.h> //
#include "board.h"
#include <Wire.h>
#include "SparkFun_SHTC3.h" // Click here to get the library: http://librarymanager/All#SparkFun_SHTC3
#include <RotaryEncoder.h> //
#include <Beastdevices_INA3221.h> //
#include "in3ator_humidifier.h"

TwoWire *wire;
MAM_in3ator_Humidifier in3_hum(DEFAULT_ADDRESS);
Adafruit_ILI9341 tft = Adafruit_ILI9341(TFT_CS, TFT_DC);
SHTC3 mySHTC3;              // Declare an instance of the SHTC3 class
RotaryEncoder encoder(ENC_A, ENC_B, RotaryEncoder::LatchMode::TWO03);
#define Rsense 3000 //3 microohm as shunt resistor
Beastdevices_INA3221 digitalCurrentSensor(INA3221_ADDR41_VCC);
#define digitalCurrentSensor_i2c_address 65
#define roomSensorAddress 112


int serialNumber = 80;
#define WDT_TIMEOUT 25

#define ON true
#define OFF false
#define BASIC_CONTROL false
#define PID_CONTROL true
#define SKIN_CONTROL false
#define AIR_CONTROL true

//buzzer variables
#define buzzerStandbyPeriod 10000 //in millis, there will be a periodic tone when regulating baby's constants
#define buzzerStandbyTone 500 //in micros, tone freq
#define buzzerAlarmTone 500 //in micros, tone freq
#define buzzerRotaryEncoderTone 2200 //in micros, tone freq
#define buzzerStandbyToneDuration 50 //in micros, tone freq
#define buzzerSwitchDuration 10 //in micros, tone freq
#define buzzerStandbyToneTimes 1 //in micros, tone freq


//configuration variables
#define debounceTime 30         //encoder debouncing time
#define timePressToSettings 3000 //in millis, time to press to go to settings window in UI
#define debugUpdatePeriod 1000 //in millis, 
bool WIFI_EN = true;
bool defaultWIFI_EN = ON;
long lastDebugUpdate;
long loopCounts;
//pages number in UI. Configuration and information will be displayed depending on the page number
int page;
#define mainMenuPage 1
#define actuatorsProgressPage 2
#define settingsPage 3
#define calibrateSensorsPage 4
#define firstPointCalibrationPage 5
#define secondPointCalibrationPage 6
#define autoCalibrationPage 7
#define fineTuneCalibrationPage 8
//languages numbers that will be called in language variable
byte language;
#define spanish 0
#define english 1
#define french 2
#define portuguese 3
#define numLanguages 4
#define defaultLanguage english //Preset number configuration when booting for first time

//number assignment of each enviromental sensor for later call in variable
#define skinSensor 0
#define airSensor 1
#define numNTC 1 //number of NTC
#define numSensors 2 //number of total temperature sensors in system

#define secondOrder_filter 3 //amount of temperature samples to filter
#define analog_temperature_filter 500 //amount of temperature samples to filter
#define digital_temperature_filter 10 //amount of temperature samples to filter
int temperature_filter = analog_temperature_filter; //amount of temperature samples to filter

#define NTCMeasurementPeriod 1000 //in millis
#define CurrentMeasurementPeriod 500 //in micros
#define CurrentUpdatePeriod 1000 //in millis
long lastNTCmeasurement, lastCurrentMeasurement, lastCurrentUpdate;

int NTC_PIN[numNTC] = {BABY_NTC_PIN};
double temperature[numSensors];
double errorTemperature[numSensors], temperatureCalibrationPoint;
double ReferenceTemperatureRange, ReferenceTemperatureLow;
double provisionalReferenceTemperatureLow;
double fineTuneSkinTemperature;
double RawTemperatureLow[numSensors], RawTemperatureRange[numSensors];
double provisionalRawTemperatureLow[numSensors];
double temperatureMaxReset = -1000;
double temperatureMinReset = 1000;
double temperatureMax[numSensors], temperatureMin[numSensors];
int temperatureArray [numNTC][analog_temperature_filter]; //variable to handle each NTC with the array of last samples (only for NTC)
int temperature_array_pos; //temperature sensor number turn to measure
float diffTemperature; //difference between measured temperature and user input real temperature
bool faultNTC[numNTC]; //variable to control a failure in NTC
double humidity; // room humidity variable
bool humidifierState, humidifierStateChange;
int previousHumidity; //previous sampled humidity
float diffHumidity; //difference between measured humidity and user input real humidity


byte autoCalibrationProcess;
#define setupAutoCalibrationPoint 0
#define firstAutoCalibrationPoint 1
#define secondAutoCalibrationPoint 2

//Sensor check rate (in ms). Both sensors are checked in same interrupt and they have different check rates
byte encoderRate = true;
byte encoderCount = false;
bool encPulseDetected;
volatile long lastEncPulse;
#define encPulseDebounce 50
volatile bool statusEncSwitch;

//WIFI
bool WIFI_connection_status = false;

//GPRS variables to transmit
#define turnedOn 0 //transmit first turned ON with hardware verification
#define room 1 //transmit room variables
#define aliveRefresh 2 //message to let know that incubator is still ON

#define digitalCurrentSensorReadPeriod 500
#define externalADCReadPeriod 30

//sensor variables
#define defaultCurrentSamples 30
#define defaultTestingSamples 8000

bool roomSensorPresent = false;
bool digitalCurrentSensorPresent = false;

float instantTemperature[secondOrder_filter];
float previousTemperature[secondOrder_filter];

//room variables
bool controlMode;
bool defaultcontrolMode = SKIN_CONTROL;
bool controlAlgorithm;
bool defaultcontrolAlgorithm = PID_CONTROL;
double desiredControlTemperature; //preset baby skin temperature
double desiredControlHumidity; //preset enviromental humidity
bool jaundiceEnable; //PWM that controls jaundice LED intensity
double desiredHeaterTemp; //desired temperature in heater

//#define system constants
#define humidifierDutyCycleMax  100 //maximum humidity cycle in heater to be set
#define humidifierDutyCycleMin 0 //minimum humidity cycle in heater to be set
const float minDesiredTemp[2] = {35, 30}; //minimum allowed temperature to be set
const float maxDesiredTemp[2] = {37.5, 37}; //maximum allowed temperature to be set
#define  stepTemperatureIncrement 0.1 //maximum allowed temperature to be set
#define  stepHumidityIncrement 5 //maximum allowed temperature to be set
const int presetTemp[2] = {36, 32}; //preset baby skin temperature
#define  presetHumidity 60 //preset humidity
#define  maxHum 90 //maximum allowed humidity to be set
#define  minHum 20 //minimum allowed humidity to be set
#define  LEDMaxIntensity 100 //max LED intensity to be set
#define  fanMaxSpeed 100 //max fan speed (percentage) to be set

//Encoder variables
#define NUMENCODERS 1 //number of encoders in circuit
#define ENCODER_TICKS_DIV 0
boolean A_set;
boolean B_set;
int encoderpinA = ENC_A; // pin  encoder A
int encoderpinB = ENC_B; // pin  encoder B
bool encPulsed, encPulsedBefore; //encoder switch status
bool updateUIData;
volatile int EncMove; //moved encoder
volatile int lastEncMove; //moved last encoder
volatile int EncMoveOrientation = -1; //set to -1 to increase values clockwise
volatile int last_encoder_move; //moved encoder
long encoder_debounce_time = true; //in milliseconds, debounce time in encoder to filter signal bounces
long last_encPulsed; //last time encoder was pulsed

//User Interface display constants
#define brightenRate  10        //intro brighten speed (Higher value, faster)
#define valuePosition 245
#define separatorPosition 240
#define unitPosition 315
#define textFontSize 2          //text default size
#define width_select  7
#define height_heading  34
#define width_indentation  4
#define width_back  50
#define side_gap  4
#define letter_height  26
#define letter_width  14
#define logo  40
#define arrow_height  6
#define arrow_tail  5
#define headint_text_height height_heading / 5
#define initialSensorsValue "XX"
#define barThickness 3
#define blinkTimeON 1000 //displayed text ON time
#define blinkTimeOFF 100 //displayed text OFF time

//Text Graphic position variables
int humidityX;
int humidityY;
int temperatureX;
int temperatureY;
int separatorTopYPos;
int separatorBotYPos;
bool controlTemperature;
bool controlHumidity;
int ypos;
bool print_text;
int initialSensorPosition = separatorPosition - letter_width;
bool pos_text[8];

//security defs
#define HUMIDITY_ALARM 0
#define TEMPERATURE_ALARM 1
#define AIR_THERMAL_CUTOUT_ALARM 2
#define SKIN_THERMAL_CUTOUT_ALARM 3
#define AIR_SENSOR_ISSUE_ALARM 4
#define SKIN_SENSOR_ISSUE_ALARM 5
#define FAN_ISSUE_ALARM 6
#define HEATER_ISSUE_ALARM 7
#define NUM_ALARMS 8

//Graphic variables
#define ERASE false
#define DRAW  true
bool enableSet;
float temperaturePercentage, temperatureAtStart;
float humidityPercentage, humidityAtStart;
int barWidth, barHeight, tempBarPosX, tempBarPosY, humBarPosX, humBarPosY;
int screenTextColor, screenTextBackgroundColor;

//User Interface display variables
bool autoLock; //setting that enables backlight switch OFF after a given time of no user actions
bool defaultAutoLock = ON; //setting that enables backlight switch OFF after a given time of no user actions
int time_lock = 16000; //time to lock screen if no user actions
const byte time_back_draw = 255;
const byte time_back_wait = 255;
long lastbacklightHandler; //last time there was a encoder movement or pulse
long sensorsUpdatePeriod = 1000;

bool selected;
char cstring[128];
char* textToWrite;
char* words[12];
char* helpMessage;
byte bar_pos = true;
byte menu_rows;
byte length;
long lastGraphicSensorsUpdate;
long lastSensorsUpdate;
bool enableSetProcess;
long blinking;
bool state_blink;
bool blinkSetMessageState;
long lastBlinkSetMessage;

//graphic text configurations
#define graphicTextOffset  1                //bar pos is counted from 1, but text from 0
#define CENTER true
#define LEFT_MARGIN false

//below are all the different variables positions that will be displayed in user interface
//mainMenu
#define controlModeGraphicPosition 0
#define temperatureGraphicPosition 1
#define humidityGraphicPosition 2
#define LEDGraphicPosition 3
#define settingsGraphicPosition 5
#define startGraphicPosition 4
//settings

#define serialNumberGraphicPosition 0
#define languageGraphicPosition 1
#define WifiENGraphicPosition 2
#define calibrateGraphicPosition 3
#define setdefaultValuesGraphicPosition 4
#define HWTestGraphicPosition 5

//calibration menu
#define autoCalibrationGraphicPosition 0
#define fineTuneCalibrationGraphicPosition 1
#define twoPointCalibrationGraphicPosition 2
#define restartCalibrationGraphicPosition 3

//2p calibration
#define temperatureCalibrationGraphicPosition 0
#define setCalibrationGraphicPosition 1

//auto calibration
#define autoCalibrationMessageGraphicPosition 0

//color options
#define BLACK 0x0000
#define BLUE 0x001F
#define RED 0xF800
#define GREEN 0x07E0
#define CYAN 0x07FF
#define MAGENTA 0xF81F
#define YELLOW 0xFFE0
#define WHITE 0xFFFF
#define COLOR_WARNING_TEXT ILI9341_ORANGE
#define COLOR_MENU BLACK
#define COLOR_BAR  BLACK
#define COLOR_MENU_TEXT WHITE
#define COLOR_SELECTED WHITE
#define COLOR_CHOSEN BLUE
#define COLOR_HEADING BLUE
#define COLOR_ARROW BLACK
#define COLOR_BATTERY BLACK
#define COLOR_BATTERY_LEFT BLACK
#define COLOR_FRAME_BAR WHITE
#define COLOR_LOADING_BAR RED
#define COLOR_COMPLETED_BAR GREEN
#define introBackColor WHITE
#define introTextColor BLACK
#define transitionEffect BLACK

#define PIDISRPeriod 1000    // in msecs
#define peripheralsISRPeriod 100000    // in milliseconds

void setup() {
  initHardware(false);
  UI_mainMenu();
}

void loop() {
  userInterfaceHandler(page, EncMove);
  updateData();
}
