pablo18393/in3ator/IN3_FW/motherBoard/src/UI_mainMenu.cpp

/*
  MIT License

  Copyright (c) 2022 Medical Open World, Pablo Sánchez Bergasa

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
*/
#include <Arduino.h>
#include "main.h"

extern TwoWire *wire;
extern MAM_in3ator_Humidifier in3_hum;
extern Adafruit_ILI9341 tft;
extern SHTC3 mySHTC3; // Declare an instance of the SHTC3 class
extern RotaryEncoder encoder;
extern Beastdevices_INA3221 digitalCurrentSensor;

extern bool WIFI_EN;
extern long lastDebugUpdate;
extern long loopCounts;
extern int page;
extern int temperature_filter; // amount of temperature samples to filter
extern long lastNTCmeasurement[numNTC];

extern double errorTemperature[numSensors], temperatureCalibrationPoint;
extern double ReferenceTemperatureRange, ReferenceTemperatureLow;
extern double provisionalReferenceTemperatureLow;
extern double fineTuneSkinTemperature;
extern double RawTemperatureLow[numSensors], RawTemperatureRange[numSensors];
extern double provisionalRawTemperatureLow[numSensors];
extern double temperatureMax[numSensors], temperatureMin[numSensors];
extern int temperatureArray[numNTC][analog_temperature_filter]; // variable to handle each NTC with the array of last samples (only for NTC)
extern int temperature_array_pos;                               // temperature sensor number turn to measure
extern float diffSkinTemperature, diffAirTemperature;                                   // difference between measured temperature and user input real temperaturee;
extern int previousHumidity;                                    // previous sampled humidity
extern float diffHumidity;                                      // difference between measured humidity and user input real humidity

extern byte autoCalibrationProcess;

// Sensor check rate (in ms). Both sensors are checked in same interrupt and they have different check rates
extern byte encoderRate;
extern byte encoderCount;
extern bool encPulseDetected;
extern volatile long lastEncPulse;
extern volatile bool statusEncSwitch;

// WIFI
extern bool WIFI_connection_status;

extern bool roomSensorPresent;
extern bool digitalCurrentSensorPresent;

extern float instantTemperature[secondOrder_filter];
extern float previousTemperature[secondOrder_filter];

// room variables
extern float minDesiredTemp[2]; // minimum allowed temperature to be set
extern float maxDesiredTemp[2]; // maximum allowed temperature to be set
extern int presetTemp[2];       // preset baby skin temperature

extern boolean A_set;
extern boolean B_set;
extern int encoderpinA;                 // pin  encoder A
extern int encoderpinB;                 // pin  encoder B
extern bool encPulsed, encPulsedBefore; // encoder switch status
extern bool updateUIData;
extern volatile int EncMove;            // moved encoder
extern volatile int lastEncMove;        // moved last encoder
extern volatile int EncMoveOrientation; // set to -1 to increase values clockwise
extern int last_encoder_move;           // moved encoder
extern long encoder_debounce_time;      // in milliseconds, debounce time in encoder to filter signal bounces
extern long last_encPulsed;             // last time encoder was pulsed

// Text Graphic position variables
extern int humidityX;
extern int humidityY;
extern int temperatureX;
extern int temperatureY;
extern int ypos;
extern bool print_text;
extern int initialSensorPosition;
extern bool pos_text[8];

extern bool enableSet;
extern float temperaturePercentage, temperatureAtStart;
extern float humidityPercentage, humidityAtStart;
extern int barWidth, barHeight, tempBarPosX, tempBarPosY, humBarPosX, humBarPosY;
extern int screenTextColor, screenTextBackgroundColor;

// User Interface display variables
extern bool autoLock;             // setting that enables backlight switch OFF after a given time of no user actions
extern long lastbacklightHandler; // last time there was a encoder movement or pulse
extern long sensorsUpdatePeriod;

extern bool selected;
extern char cstring[128];
extern char *textToWrite;
extern char *words[12];
extern char *helpMessage;
extern byte bar_pos;
extern byte menu_rows;
extern byte length;
extern long lastGraphicSensorsUpdate;
extern long lastSensorsUpdate;
extern bool enableSetProcess;
extern long blinking;
extern bool state_blink;
extern bool blinkSetMessageState;
extern long lastBlinkSetMessage;


extern double HeaterPIDOutput;
extern double skinControlPIDInput;
extern double airControlPIDInput;
extern double humidityControlPIDOutput;
extern int humidifierTimeCycle;
extern unsigned long windowStartTime;

extern PID airControlPID;
extern PID skinControlPID;
extern PID humidityControlPID;

extern in3ator_parameters in3;

void UI_mainMenu()
{
  page = mainMenuPage;
  byte numWords = 5;
  print_text = true;
  tft.setTextSize(1);
  tft.setTextColor(COLOR_MENU_TEXT);
  for (int i = false; i < numWords; i++)
  {
    pos_text[i] = LEFT_MARGIN;
  }
  pos_text[startGraphicPosition] = CENTER;
  switch (in3.language)
  {
  case spanish:
    words[controlModeGraphicPosition] = convertStringToChar("Modo de control");
    if (in3.controlMode)
    {
      words[temperatureGraphicPosition] = convertStringToChar("Temp aire");
    }
    else
    {
      words[temperatureGraphicPosition] = convertStringToChar("Temp piel");
    }
    words[humidityGraphicPosition] = convertStringToChar("Humedad");
    words[LEDGraphicPosition] = convertStringToChar("Fototerapia");
    break;
  case english:
    words[controlModeGraphicPosition] = convertStringToChar("Control mode");
    if (in3.controlMode)
    {
      words[temperatureGraphicPosition] = convertStringToChar("Air temp");
    }
    else
    {
      words[temperatureGraphicPosition] = convertStringToChar("Skin temp");
    }
    words[humidityGraphicPosition] = convertStringToChar("Humidity");
    words[LEDGraphicPosition] = convertStringToChar("Phototherapy");
    break;
  case french:
    words[controlModeGraphicPosition] = convertStringToChar("Mode de controle");
    if (in3.controlMode)
    {
      words[temperatureGraphicPosition] = convertStringToChar("Temp air");
    }
    else
    {
      words[temperatureGraphicPosition] = convertStringToChar("Temp peau");
    }
    words[humidityGraphicPosition] = convertStringToChar("Humidite");
    words[LEDGraphicPosition] = convertStringToChar("Phototherapie");
    break;
  case portuguese:
    words[controlModeGraphicPosition] = convertStringToChar("Modo de controle");
    if (in3.controlMode)
    {
      words[temperatureGraphicPosition] = convertStringToChar("Temp do ar");
    }
    else
    {
      words[temperatureGraphicPosition] = convertStringToChar("Temp pele");
    }
    words[humidityGraphicPosition] = convertStringToChar("Umidade");
    words[LEDGraphicPosition] = convertStringToChar("Fototerapia");
    break;
  }
  words[startGraphicPosition] = convertStringToChar("");
  menu_rows = numWords;
  setSensorsGraphicPosition(page);
  graphics(page, in3.language, print_text, menu_rows, in3.controlMode, in3.phototherapy);
  drawHeading(page, in3.serialNumber);
  updateDisplaySensors();
  in3.temperatureControl = false;
  in3.humidityControl = false;
  enableSet = false;
  bar_pos = true;
  selected = false;
  ypos = graphicHeight(bar_pos - 1);
  if (in3.desiredControlTemperature < minDesiredTemp[in3.controlMode] || in3.desiredControlTemperature > maxDesiredTemp[in3.controlMode])
  {
    in3.desiredControlTemperature = presetTemp[in3.controlMode];
  }
  while (!GPIORead(ENC_SWITCH))
  {
    updateData();
  }
  vTaskDelay(debounceTime / portTICK_PERIOD_MS);
}
