pablo18393/in3ator/(commit log)

2018-06-25 added leds feature
2018-08-14 PID V1.0
2019-06-28 moved to STM32F103RE hardware
2019-07-01 added correct name and pinout for hardware version
    [IN3_FW.ino, actuatorsProgress.ino, board.h, menu.ino, settings.ino]
2019-07-07 minor fixes, added gestation weeks variable. Pending fix asleep function and progress page freeze
    [IN3_FW.ino, actuatorsProgress.ino, advancedMode.ino, mainMenu.ino]
2019-07-11 fixed timers issues
2019-07-16 added enable power to GSM module
2019-09-04 added BME280 sensor
2019-09-16 added BME280 sensor reads
2019-09-23 Added more comments, minor timer changes
2019-09-30 encoder with external interrupts
2019-10-01 fixed humidifier display bug in mainMenu
    [board.h, mainMenu.ino]
2019-10-02 added debounce code to encoder
2019-10-02 changed encoder direction
2019-10-02 fixed display bug that doesnt allow to select last row
    [IN3_FW.ino]
2019-11-06 first working GSM firmware. Pending build the rest of the firmware and use internal interrupts
2019-11-08 continue with GSM firmware. Added interrupts priorities
2019-11-11 continue with GSM firmware. Working with 64 byte uart buffer
2019-11-15 continue with GSM firmware, not working yet
    [IN3_FW.ino, board.h]
2019-11-25 fixed minor GSM bugs, working version
    [IN3_FW.ino, SD.ino, board.h]
2019-11-26 bq temperature and humidity log v1
2019-11-27 bq temperature and humidity log v2
2019-11-27 bq temperature and humidity log v3, added zero avoider
2019-11-27 bq temperature and humidity log v4, added zero avoider
    [SD.ino]
2019-11-29 bq temperature and humidity log working fw
2019-11-29 minor encoder fix
2019-12-04 added humidifier timer configuration
2019-12-11 added 2 more NTC and some minor pin changes
2019-12-11 fixed GPRS variables for new database, added 2 internal NTC pins
    [SD.ino, board.h]
2019-12-13 added POST and login differences for optimal data throuput. ISSUE: comment not clearing
    [board.h]
2019-12-28 added bootloader file
    [Actuators.SchDoc, BOM_PartType-in3ator.xls, Buzzer.SchDoc, GSM.SchDoc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]
2019-12-30 optimized BME280 sensor handle
    [Actuators.SchDoc, BOM_PartType-in3ator.xls, Buzzer.SchDoc, GSM.SchDoc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]
2020-01-01 correct timers handling
2020-01-10 added GPRS variables updated, current measurements, fixed heater and fan pwmWrites, updated maximum screen pwm rate
    [IN3_FW.ino, actuatorsProgress.ino]
2020-01-10 continue with hardware verification, minor fixes
    [IN3_FW.ino, actuatorsProgress.ino]
2020-01-21 added 3d parts
    [Diffuser.stl, HeaterSupport.stl, HighPowerFanSupport.stl, LowPowerFanHolder.stl, Window cover.stl, electronicsBox_V1.stl, humidifierPart1.STL, humidifierPart2.STL]
2020-01-22 updated part
    [HeaterSupport.stl, HeraterSupport.stl]
2020-01-22 adding minor changes
    [HighPowerFanSupport.stl, WindowCover.stl]
2020-01-23 minor name change
    [HeaterSupport.stl, HighPowerFanHolder.stl]
2020-02-04 minor changes
    [humidifierPart2_v2.STL]
2020-04-13 changed tree directory
    [humidifierPart2_v2.STL, humidifierPart3_v2.STL]
2020-07-18 added STM32CubeIDE project, non stable version
2020-08-27 update FW, added STM32CubeIDE folder
    [Actuators.SchDoc, BOM_PartType-in3ator.xls, Buzzer.SchDoc, GSM.SchDoc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]
2020-09-08 released V2.B
    [Actuators.SchDoc, BOM_PartType-in3ator.xls, Buzzer.SchDoc, ESD_Protection.SchDoc, GSM.SchDoc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]
2021-03-06 Added humidifier to backup mosfet, fixed timers, fixed GPRS freeze bug, updated board.h to hardware 4.A version
    [Diffuser.stl, HeaterSupport.stl, HighPowerFanHolder.stl, LowPowerFanHolder.stl, WindowCover.stl, electronicsBox_V1.stl, humidifierPart1.STL, humidifierPart2.STL]
2021-04-22 V5.A version
    [Actuators.SchDoc, BOM_PartType-in3ator.xls, Buzzer.SchDoc, Distanciador cama v3 v4.step, Distanciador cama v3 v4.stl, ESD_Protection.SchDoc, Electronic_support v13.stl, GSM.SchDoc]
2021-05-06 updated to hardware version 5.A
    [Electronic_support v14.stl]
2021-05-06 added portuguese language
    [Electronic_support v13.stl]
2021-05-09 added right and left doors
    [Cover_door_left_6.stl, Cover_door_right_6.stl, Cover_knob_left_V6.stl, Cover_knob_right_V6.stl, Cover_knobfit_left_V6.stl, Cover_knobfit_right_V6.stl, Cover_ring_left_V6.stl, Cover_ring_right_V6.stl]
2021-05-11 added current consumption offset logic
    [Cover_door_left_V6.stl, Cover_door_right_V6.stl]
2021-05-12 added buzzer (pending optimization and alarms
    [IN3_FW.ino]
2021-05-25 fixing minor errors
    [Cover_door_V10.stl, Cover_door_left_V6.stl, Cover_door_right_V6.stl, Cover_knob_left_V10.stl, Cover_knob_left_V8.stl, Cover_knob_right_V10.stl, Cover_knob_right_V8.stl, Cover_knobfit_left_V10.stl]
2021-05-25 added power alarm
2021-05-27 fixed serial hang bug
    [IN3_FW.ino]
2021-05-29 developing hardware verification, minor GPRS fixes
    [IN3_FW.ino]
2021-05-30 added buzzer tone to user interactions
    [IN3_FW.ino, actuatorsProgress.ino]
2021-05-30 enhanced rotary encoder
2021-06-01 changed HW, tuned current sensor
    [Electronic_support v19.stl]
2021-06-02 added heater and debug UI configuration
2021-06-02 added encoder clockwise orientation for upwards values change
2021-06-02 added antialiasing heater current sensing
2021-06-06 fixed PID max limits
    [Cover_knob_left_V10.stl, Cover_knob_right_V10.stl]
2021-06-11 fixed humidifier pin
2021-06-11 deleted current sensing test, giving issues
    [IN3_FW.ino, settings.ino]
2021-06-13 added alarms, optimized buzzer, pending alarms graphic UI
    [IN3_FW.ino, actuatorsProgress.ino, settings.ino]
2021-06-13 progressing with alarms, pending display error
    [IN3_FW.ino, ISR.ino, actuatorsProgress.ino, settings.ino]
2021-06-13 chaged LED display name to phototherapy
2021-06-13 added alarm UI, fixed actuators progress page display names
    [IN3_FW.ino, actuatorsProgress.ino]
2021-06-13 temperature and humidity alarms UI
2021-07-10 added backlight PWM
2021-07-10 changed default autolock to ON to avoid overcurrent restart
    [IN3_FW.ino]
2021-08-07 fixed analog readings corrupted by timer 4 frequency change
    [IN3_FW.ino]
2021-08-08 first PID calibration, added air NTC measurement
2021-08-08 code refactoring, added humidity PID, tuned humidity PID values, fixed some PID bugs
    [IN3_FW.ino, ISR.ino, actuatorsProgress.ino, advancedMode.ino, mainMenu.ino, settings.ino]
2021-08-08 fixed power en routine in hardware verification
2021-10-04 added ESP32 HW version, pending test and minor functionalities
    [CablesCover v2.stl, Cover_knob_left_V15.stl, Cover_knob_right_V15.stl, Electronic_support v21.stl, RotaryKnob.step, RotaryKnob.stl]
2021-10-04 added current sensing, pending optimizations
2021-10-05 fixed white error screen, buzzer routines and aditional push buttons
    [IN3_FW.ino, ISR.ino, board.h]
2021-10-05 added basic OTA funcionality. Pending security enhancements and initial boot time issue
    [IN3_FW.ino]
2021-10-06 fixed OTA startup hang
    [IN3_FW.ino]
2021-10-06 fixed shtc3 writing in temperature wrong position array
    [IN3_FW.ino]
2021-10-07 fixed heater not working
    [IN3_FW.ino, ISR.ino, board.h]
2021-10-08 minor fixes and added fan pin in gpio expander
    [actuatorsProgress.ino, board.h]
2021-10-08 fixed PID not working, GPRS shut down due to inrush current when turning on
    [actuatorsProgress.ino, board.h]
2021-10-09 overrided hw test, fixed EEPROM difftemperature
    [IN3_FW.ino]
2021-10-17 added new menu to ESP32 code
2021-11-09 added calibration of both NTC and fast calibration. Enhanced NTC readings
2021-11-25 added watchdog, added analog current sensing
2021-11-29 changed temperature trigger to 1ºC
2021-11-29 fixed current sensing interval
    [IN3_FW.ino, ISR.ino]
2021-12-02 updated ESP32 libraries
2021-12-10 added 2 point temperature calibration
2021-12-10 fixed analog sensor data array overflow
    [IN3_FW.ino]
2021-12-12 decreased i2c bus frequency, update TCA9355 outputs in case of corruption
2021-12-13 Fix TCA9355 write overload when humidifing
    [IN3_FW.ino, actuatorsProgress.ino]
2021-12-13 Changed humidifier PID properties
2021-12-23 graphic flow optimization, pending settings fix
    [IN3_FW.ino, actuatorsProgress.ino, advancedMode.ino, mainMenu.ino, settings.ino]
2021-12-24 Fix calibration division by zero
2021-12-28 Fixed calibration method
2022-01-12 added ST7789v display, optimized code, pending random reboots fix issue
    [IN3_FW.ino, actuatorsProgress.ino, board.h]
2022-01-13 optimized ADC ready read
2022-01-17 Fixed random ISR due to wifi bug
    [IN3_FW.ino, ISR.ino, board.h]
2022-01-17 disabled external ADC and digital current sensor, added serialNumber config
2022-02-28 added default calibration values
2022-03-30 Hardware version 8.A. Fixed I2C address issue, changed variables names, fixed default temperature calibration, added PWM humidifier mode, tuned PID
    [Actuators.SchDoc, BOM_PartType-in3ator.xls, Buzzer.SchDoc, ESD_Protection.SchDoc, GSM.SchDoc, Power_Input.SchDoc, Power_management.SchDoc, Screen.SchDoc]
2022-03-30 version 8.B files
    [CablesCover v2.stl, Cover_door_V15.stl, Cover_knob_left_V15.stl, Cover_knob_right_V15.stl, Cover_knobfit_left_V10.stl, Cover_knobfit_right_V10.stl, Cover_ring_V15.stl, Distanciador cama v3 v4.step]
2022-04-05 deleted pulsioximeter code, fixed mean current measurement
    [IN3_FW.ino]
2022-04-05 fixed startup current checks
    [IN3_FW.ino, actuatorsProgress.ino, board.h]
2022-04-06 fixed current sensing
2022-04-06 applied butterworth filter to temperature sensing
2022-04-06 applied butterworth filter TO Humidifier current sensor
2022-04-14 added auto calibration feature (pending optimize)
2022-04-14 add temperatures to discard in case of error
    [board.h]
2022-04-14 add air control PID
2022-04-15 calibration optimize
2022-04-15 variables renaming, fixing minimum and maximum temperature settings to meet IEC 60601
    [IN3_FW.ino, actuatorsProgress.ino, mainMenu.ino]
2022-04-18 air PID control fix
    [IN3_FW.ino]
2022-04-18 PID control fix
2022-04-18 changed filter to 0.8hz
2022-04-18 fixed maximum and minimum temperature and humidity values in conpliance with IEC60601
    [IN3_FW.ino]
2022-04-19 fixed delay alarm to 30 min
    [IN3_FW.ino]
2022-04-19 fixed ADC reading to current factor
    [IN3_FW.ino]
2022-04-20 automatic calibration feature
2022-04-21 added sensor security alarms
2022-04-21 code refactoring, added heater disconnection in case of sensor failure
    [actuatorsProgress.ino]
2022-04-23 fixed fan test issue
    [actuatorsProgress.ino]
2022-04-23 control temperature stored in EEPROM
2022-05-25 minor UI calibration changes
2022-05-25 disable alarms when calibrating
2022-05-25 fixed possible divZero bugs and alarms
    [Buzzer.ino, IN3_FW.ino, ISR.ino]
2022-05-25 fixed cutout alarm bug not re-enabling heater
    [IN3_FW.ino]
2022-05-29 fixed minor user interface issues
    [IN3_FW.ino, ISR.ino]
2022-06-27 fixed string to char issue
    [IN3_FW.ino]
2022-09-03 asigned external interrupt to encoder switch
2022-09-04 added i2c communication to humidifier
2022-09-05 fixed display brightness and current sensor configuration
    [IN3_FW.ino, board.h]
2022-09-13 enhanced current sensor values, fixed fan test, fixed main shunt value
    [IN3_FW.ino, board.h]
2022-10-23 code refactoring, pending issues
    [IN3_FW.ino, SD.ino]
2022-11-13 added system voltage monitoring
2022-11-13 fixed current test stabilization times
2022-11-13 removed fan test
2022-11-14 changed WIFI device name
2022-11-15 Wrong fan wiring protection
2022-11-15 Fixed help UI message not dissapearing
    [main.h]
2022-11-15 Autoprovisioning feature, pending library fix
    [main.h]
2022-11-21 fixed ISR hanging due to log
    [main.cpp]
2022-11-24 deteled factory calibration
2022-11-25 Version 6.B, pending to fix ongoingCrititalAlarm
    [UI_mainMenu.cpp, board.h, main.cpp, main.h]
2022-11-30 fixed GPIOWrite function and minor graphic bugs
    [board.h, main.h]
2022-12-01 code refactoring, UI fixes, pending PID bug fix
    [UI_mainMenu.cpp, board.h, main.cpp, main.h]
2022-12-02 fixed PID issue
2022-12-24 fixed display wrong SPI clk, minor changes
    [UI_mainMenu.cpp, board.h, main.cpp, main.h]
2022-12-24 added thingsboard header due to short buffer allocation
    [ThingsBoard.h]
2022-12-28 added firmware ota fix
    [ThingsBoard.h]
2023-01-01 reorder folders
    [Actuators.SchDoc, BOM_PartType-in3ator.xls, Buzzer.SchDoc, ESD_Protection.SchDoc, GSM.SchDoc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]
2023-01-01 fixed SHTC3 crash error, changed PID compute time
    [UI_mainMenu.cpp, board.h, main.cpp, main.h]
2023-01-01 added adc reading correction
    [main.cpp]
2023-01-03 added calibration error
2023-01-03 WIFI MQTT Publish, WIFI OTA crashes
    [board.h, main.h]
2023-01-04 fixed OTA crash, enhanced thingsboard
    [main.cpp, main.h]
2023-01-07 added active time track to thingsboard
2023-01-08 added custom partition file
    [in3ator_OTA_partition.csv]
2023-01-10 added config for 6.B version, fixed GPIO num error
    [board.h]
